migueldiaslima/drone-revB/README.md

# drone-revB

Quadcopter frame rev B (3.5 inch true X, PET-CF, topology-optimised with Abaqus/Tosca). Owner: Miguel Dias de Lima.

## Layout

| Folder | Content |
|---|---|
| `docs/` | All project docs, plus the Stage 2 theory document `stage2_sizing_model_first_principles_rev34.md` / `.pdf` (Chapters 0 to 10, Appendices A and B, references; Claude Docs rev 34) (copies of the claude.ai project "Drone Rework"). `journal_quadcopter.md` is the master record |
| `geometry/v04B/` | Current export, v04-B revision 2: TUB, LID, ARM_xx, KEEPOUTS, COMPONENTS (STEP), reference points, volumes and gate results |
| `geometry/v03B_arms/` | v03-B arm STEPs (D-054 split), kept for reference |
| `scripts/geometry_main/` | Main-chat generators and gates (CadQuery, gmsh, renders) |
| `scripts/cae_v03B/` | Abaqus/CAE 2022 scripts for the v03-B model (R1 to R13) |
| `scripts/cae_v04B/` | Abaqus/CAE 2022 scripts for v04-B (V1 build, V2 mesh, V3 jobs, W1/W2 Tosca task, D1 diagnostics) |
| `scripts/hpc/` | nexus run scripts and checks per run: H0H1, H2, H3ref, H3, G7, H4, threshold, TH04 |
| `scripts/post/` | Post-processing (iso surfaces, cycle checks) |
| `figures/` | Figures used in the docs |

Not in the repo (size): odb, inp, par, cae, stl. Those live on nexus (`/tmp/mdias_*`, `~/drone_revB/stage6`) and on Miguel's laptop.

## Status (2026-10-14)

| Item | State |
|---|---|
| Journal | v0.60 (D-001 to D-090) |
| Build log | items 1 to 69, DV-1 to DV-28 |
| H4 (v04-B rev 2) | converged at cycle 31; TH04b_ni passes, TH04a_ni fails as expected (N-06-17, N-06-18); antenna boss island F-036 |
| v04-B revision 3 (D-084, antenna spine) | exported to `geometry/v04B_r3/`, gates G0 to G5 pass (`docs/stage6_v04B_r3_export_note.md`); boss 5 island in H4 cycle 31 (F-037) |
| v04-B revision 4 (D-086, GPS deck on the TUB, four lid bosses) | exported to `geometry/v04B_r4/`, gates G0 to G5 pass (`docs/stage6_v04B_r4_export_note.md`) |
| H4 (v04-B rev 4) | converged at cycle 28; TH at iso 0.4 fails on the GPS deck (F-038); keels A + B with the keel zone cleaned pass (TH_r4b_cAB, N-06-21) |
| Keels A and B (D-087) | exact solids in `geometry/v04B_r4_keels/` (`docs/stage6_v04B_r4_keels_export_note.md`) |
| Receiver cradle, GPS cap | v2 in `geometry/retainers/` (`docs/retainer_rx_cradle_note.md`, `docs/retainer_gps_cap_note.md`) |
| Stages 6 and 7 | closed 2026-10-14: print set iso 0.3 (frame 89.22 g), strength PASS (about 25 x), D-050 not met (F-040, D-090); `docs/stage6_v04B_H4_report.md`, `docs/stage7_strength_report.md` |
| Reports | done 2026-10-14: compact (17 pages, sent) and extensive (123 pages) in `report/`; build zips with `bash report/make_overleaf.sh` |

## Open tasks

| # | Task | Owner |
|---|---|---|
| 1 | Report (about 15 pages, LaTeX) from journal Section 4 | Miguel, main chat |
| 2 | TPU skid | main chat |
| 3 | Q-58, Q-59, Q-63 (GPS wiring, plugs, height); Q-60 at the first cradle fit | Miguel |
| 4 | Future work: joint redesign for a defined up-down fuse (D-090); mass against R-01 (F-039) | - |

See `CLAUDE.md` for the working rules.
