migueldiaslima/drone-revB/report/extensive/main.tex

\documentclass[a4paper,11pt,oneside,parskip=half,toc=bibliography]{scrreprt}
\input{../common/preamble}
\input{../common/macros}
\title{From first principles to a printed airframe}
\subtitle{Sizing, topology optimisation and verification of a 3.5-inch quadcopter in PET-CF\\[4pt]
  \normalsize 3.5-inch quadcopter frame, Siraya PET-CF, Abaqus/Tosca}
\author{Miguel Dias de Lima\\ \small migueldiaslima@gmail.com}
\date{Latest revision: October 2026}
\begin{document}
\begin{titlepage}
\centering
\vspace*{\fill}
\par
\vspace{14mm}
{\usekomafont{title}\Huge From first principles to a printed airframe\par}
\vspace{5mm}
{\usekomafont{subtitle}\large Sizing, topology optimisation and verification of a 3.5-inch quadcopter in PET-CF\par}
\vspace{3mm}
{\normalsize 3.5-inch quadcopter frame, Siraya PET-CF, Abaqus/Tosca\par}
\vspace{12mm}
{\Large Miguel Dias de Lima\par}
\vspace{2mm}
{\small migueldiaslima@gmail.com\par}
\vspace{10mm}
{\normalsize Latest revision: October 2026\par}
\vspace*{\fill}
\end{titlepage}
\tableofcontents
\input{chapters/01_introduction}
\input{chapters/02_requirements}
\input{chapters/03_sizing}
\input{chapters/04_loads}
\input{chapters/05_material}
\input{chapters/06_architecture}
\input{chapters/07_topopt_theory}
\input{chapters/08_optimisation_model}
\input{chapters/09_iterations}
\input{chapters/10_verification}
\input{chapters/11_strength}
\input{chapters/11b_capacity}
\input{chapters/12_retainers}
\input{chapters/13_results}
\appendix
\input{chapters/A_logs}
\input{chapters/B_workflow}
\bibliographystyle{unsrtnat}
\bibliography{../common/references}
\end{document}
