migueldiaslima/drone-revB/report/compact/sections/07_iterations.tex

% 07_iterations.tex
\section{Verification and design-space iterations}\label{sec:iterations}

The optimiser returns a density field, not a part. The printed part is the region above an iso level of that field, so every result is verified on its thresholded form: elements above the iso level are solid, all others are set to near-zero stiffness, and the modes and compliances are recomputed. Three findings came out of this check, and each changed the design space.

\subsection{Disconnected fixed region at the antenna mount}

The receiver antenna was first held by a small fixed boss under the rear keel. In the optimisation that boss touched only design material and carried no load and no mass, because the antenna mass sat in a lumped point mass at the flight controller. Nothing required a path to it, so Tosca removed the keel material around it. Thresholded, the boss was a loose part with six rigid-body modes between 45 and 200\,Hz. The fix routed the antenna cable through a fixed sleeve that runs from the bay into the keel, ends in a pad under the keel and joins the rear lid boss, so the mount can no longer be cut loose, and the antenna mass now acts on that pad. This became a design-space rule: every fixed region either touches other fixed material or carries a load, a tie or a mass that needs a solid path.

\subsection{Inter-part dependency of fixed regions}

The rule was then applied part by part. A lid boss on the keel carried the tie to the lid, and in the assembled model the lid held it. Checked on the tub alone, the boss was an island: the optimiser had used the lid as its support and removed the keel behind it. The GPS deck, then part of the lid, also hung from the lid. The deck moved to the tub, on top of the keel, and the keel boss was deleted, so the GPS mass needs a load path through the tub and the lid no longer supports anything it does not own.

\subsection{Intermediate-density support of the GPS deck}

With the deck on the tub the connectivity check passed at every iso level from 0.3 to 0.5, yet the thresholded model failed: the first elastic mode was a GPS deck mode at \SI{146.8}{Hz}. In the optimisation the deck was carried at \SI{461.7}{Hz} by a wide block of keel material with densities mostly below 0.15. Such material is penalised in stiffness but still contributes, and no threshold keeps it, so the printed deck hung from two thin straps.

Five supports were tested on the saved density field without a new optimisation (\cref{tab:keels}). A local low threshold failed, so the optimiser had not formed a structure there at all. Two full side webs passed. Web B alone does not reach the deck and fails. The adopted design cleans the keel zone of all design material and adds two shapes drawn by hand: twin tapered keels hanging from the deck (A), whose depth grows towards the rear wall where their bending moment is largest, and a thin web under the antenna sleeve (B) that braces the antenna mount (\cref{fig:keels}).

\begin{table}[htbp]
\centering\small
\caption{Supports for the GPS deck, checked on the thresholded density field of the production run.}\label{tab:keels}
\begin{tabular}{@{}lcccc@{}}
\toprule
Support & Model mass & First elastic mode & LC3a compliance / cap & Result\\
\midrule
As optimised, iso 0.4 & \SI{281.3}{g} & \SI{146.8}{Hz} & 1.20 & fail\\
Local iso 0.15 in the keel & \SI{281.5}{g} & \SI{380.6}{Hz} & 0.99 & fail\\
Two side webs & \SI{283.4}{g} & \SI{430.7}{Hz} & 0.93 & pass\\
Keel zone cleaned, web B only & \SI{281.1}{g} & \SI{7.8}{Hz} & 28.05 & fail\\
Keel zone cleaned, keels A & \SI{282.2}{g} & \SI{420.7}{Hz} & 0.95 & pass\\
Keel zone cleaned, keels A and web B & \SI{282.3}{g} & \SI{428.4}{Hz} & 0.94 & pass\\
\bottomrule
\end{tabular}
\end{table}

Keels A and web B meet every requirement with \SI{1.1}{g} less than the side webs at the same margins. Their exact solids were drawn for printing: each end stops with a face at least 1\,mm deep, and every piece is at least 1.2\,mm wide.

\begin{figure}[htbp]
\centering
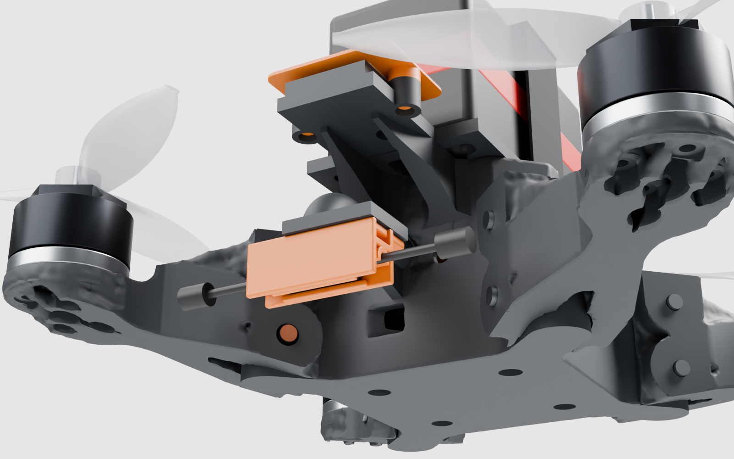
[picture p8: report/figures/R5_rear_underside.png]

\caption{Rear underside of the tub: twin keels under the GPS deck, the web under the antenna sleeve, the antenna pad and holder.}\label{fig:keels}
\end{figure}

The lesson is that connectivity is not stiffness. The connectivity rule became a stiffness rule: a fixed part that carries a mass gets either a fixed load path to the main structure or a design corridor narrow enough that the optimiser must form a member in it, and the thresholded model, not the island check, decides. Running a coarse rehearsal and a thresholded check on its saved cycles before a long production run would have shown this in hours.
