migueldiaslima/drone-revB/docs/stage6_update_since_H1.md

# Stage 6: update for the main chat, from H1 to the v04-B redesign

From the Abaqus set-up chat, 2026-10-11. Covers everything since the last message to the main chat (H0 and H1 passed, 2026-10-09 evening). Read with:
- `claude/stage6_v04B_design_brief.md`: the redesign brief (part B of this update);
- `claude/stage6_hpc_H2_report.md`: H2 and the H3 interim (written 2026-10-10 morning, superseded where this note differs);
- `claude/stage6_concepts_explained.md`: explanations of the density field, iso surfaces, member size, mode check and the measured Tosca interpolation;
- `claude/stage6_build_log_v03B.md`: full record, Phase H items 7 to 31, DV-19 to DV-21, F-15, F-16.

## 1. Summary

| Item | Result |
|---|---|
| H2 (2.5 / 1.5 mm, nemix) | stopped at cycle 10 by the D-066 mode rule; not converged |
| H3 reference (1.0 mm, nexus) | done; mesh-converged against 2.5 / 1.5 within 1.3 % (frequency) and 1.8 % (strain energy); H3 caps set |
| H3 (1.0 mm, member size 2.5 mm, nexus) | started before the H2 review (DV-21); feasible from cycle 28; stopped by hand after cycle 40 |
| D-066 items 1 to 3 | closed: interpolation measured; flagged modes are grey arm bending modes, not spurious; thresholded designs at iso 0.3 and 0.5 pass every constraint and are stiffer than Tosca predicted |
| Print set v03-B | cycle 40 at iso 0.4, smoothed, interfaces restored: body 45.58 g, arm 7.81 g, frame 76.8 g, AUW about 282 g |
| R-01 (AUW < 250 g) | not met; Miguel: 250 g is not achievable with this concept, accepted; mass for assembly features accepted |
| F-16 | the print set cannot be assembled: the FC bay is closed on every side |
| Redesign v04-B | optimised tub plus removable lid, a dedicated retainer for every component, new GPS, capacitor flipped over the FC (option 2, confirmed by Miguel); brief written |

## 2. Decisions received and how they were applied

| Decision | Applied as |
|---|---|
| D-064 (3-2-1 supports with inertia relief) | already in the model (DV-18); every run reported the reactions |
| D-065 (H2 settings) | applied with two deviations made at Miguel's request: DV-19 (resources) and DV-20 (save every cycle) |
| D-066 (C-3 checks) | item 2 automated in a watcher on H2 and in `cyclecheck.py` on H3; items 1 and 3 answered from H3 cycle 40 (section 6) |

## 3. H2 on nemix

1. Bench before H2 (Miguel: nemix free for full use, finish as fast as possible). H0 input at 32 cores: 88 s against 137 s at 16 cores, results identical to H0 (reactions below 2.5e-11 N). Memory does not speed the run (peak 9 GB). Resources raised to 32 cores, thread mode, memory 90 % (DV-19).
2. Save rule: every cycle instead of every 5 (DV-20). Reason: the every-N syntax of the Tosca 2025 save rule could not be confirmed, and a wrong edit could lose the results; disk was not a limit (2.8 TB free).
3. F-15. The first start failed in cycle 0: Abaqus 2025 does not support adjoint sensitivities with inertia relief, nor with the eigenvalue step, in MPI mode, and at 32 cores across two sockets it chose MPI (at 16 cores in H0 and H1 it had chosen threads). Fix: `mp_mode=threads` in the `.par` solver arguments (`driver.Solver.AddCallArgs = ['cpus=32','memory=90%','mp_mode=threads']`). The second start failed because `mp_mode` had also been put on the `abq2025 optimization` command line, which rejects it. Third start ran (00:46, 2026-10-10).
4. Watcher (`h2_watch.sh` with `h2_modecheck.py`): every 60 s it checked the saved odb of cycles 5, 10, ... and stopped H2 on a D-066 flag. Two bugs fixed during the night: zero-padded cycle numbers read as octal by bash (fixed with `10#`), and a support-reaction check that printed 0 N because the Tosca odb flattens the model into one instance (`PART-1-1`) so the assembly node sets were not found (fixed later in `cyclecheck.py`).
5. Stop. The watcher stopped H2 at cycle 10 (01:28): modes 8, 9, 10 (417.0 / 418.2 / 419.7 Hz) had most of their peak nodes in elements below density 0.3, at the arm tips. Constraints at the stop: f7 407.3 Hz, LC3a strain energy 1.24 x cap. About 3.8 min per cycle at 32 threads, 11 GB on disk. History table: `claude/stage6_hpc_H2_report.md`.

## 4. Second machine (nexus) and the 1.0 mm reference

1. Miguel had access to a second server (nexus: 2 x AMD EPYC 7513, 64 cores, 251 GB, Abaqus 2024). Used it so that the production mesh could be prepared in parallel with the H2 review.
2. `R13_mesh10.py` remeshed BODY and ARM at 1.0 mm in a Save As copy (`revB_v03B_m10.cae`) and wrote `H3_ref.inp`.
3. H3 reference job: 723,474 C3D10, 3.19 M variables, 671 s on 64 threads, peak 80 GB.

| Quantity | 1.0 mm | 2.5 / 1.5 mm | Difference |
|---|---|---|---|
| Mass | 333.69 g | 333.70 g | 0.00 % |
| f7 to f12 (Hz) | 486.66 / 517.87 / 520.97 / 568.67 / 673.31 / 742.66 | 489.93 / 521.51 / 524.32 / 573.63 / 681.81 / 749.44 | -0.6 to -1.3 % |
| ALLSE LC1 / LC2a / LC2b / LC3a (N mm) | 0.0919015 / 0.0709504 / 0.0461905 / 0.106569 | 0.090893 / 0.069877 / 0.045459 / 0.10466 | +1.1 to +1.8 % |
| H3 caps (D-063, 2 x ALLSE) | 0.183803 / 0.141901 / 0.0923811 / 0.213138 | | |
| Support reactions | below 3.7e-10 N | below 1.5e-11 N | |

4. S24 smoke test (Tosca 2024 on nexus, H1 files, 2 cycles): identical to H1; Tosca 2024 accepts inertia relief with the sensitivity-based algorithm. PASS.

## 5. H3 on nexus

1. Started about 02:00 on 2026-10-10, before the main chat had reviewed H2 (DV-21). Miguel's reason: deadline; the risk of a wasted run was accepted.
2. Settings: 1.0 mm mesh, H3 caps, member size 2.5 mm (`GR_MS`, minimum thickness, on `DESIGN_ALL`), max 60 cycles, save every 10 plus the last, 54 cores (10 left to another user), thread mode, memory 80 %, run directory `/tmp` (root disk 567 GB free; `/home` had 38 GB). Otherwise as H2.
3. History: overshoot at cycles 13 to 20 (volume down to 27,159 mm^3, f7 down to 341 Hz, LC3a up to 1.98 x cap), recovery from cycle 25, all constraints within about 1 % from cycle 28, then a slow volume decrease (about -0.8 % per cycle). About 14 min per cycle.
4. Mode check (`cyclecheck.py`): cycle 10 clean; cycle 20 modes 9 and 10 flagged; cycle 30 all six modes flagged (every one peaking at an arm tip, mean density in the peak region 0.20 to 0.34). Reactions below 9.8e-10 N in every step.
5. Miguel did not stop H3 until the question "can we still extract a printable structure?" was answered. It was answered with the iso surfaces of cycle 33 (section 7), and H3 was stopped after cycle 40 (12:37). Cycle 40 was frozen (`TO_v03B_H3-Job.inp` from `SAVE.inp/040`, `tosca_distribution.inp`, `c40.odb`). The pruner had deleted the cycle 32 odb, so cycle 33 was used for the first surfaces.
6. Cycle 40 (Tosca): f7 to f12 = 417.8 / 419.7 / 420.5 / 427.3 / 487.1 / 521.2 Hz; SE / cap = 0.98 / 1.00 / 1.00 / 1.00. Feasible, active on f7 and the three strain-energy cases LC2a, LC2b, LC3a.

## 6. D-066 closed

### Item 1: how Tosca treats grey material

Tosca 2024 writes each element's interpolated stiffness and mass as `*SCALESTIFFNESS` / `*SCALEMASS` distribution tables in the saved input, so the interpolation was measured rather than looked up. Mass is linear in density (100 x lower at density 0.001). Stiffness is about 0.19 x density at low density and rises towards density^3 near 1. The stiffness-to-mass ratio of intermediate material is below that of solid at every density: grey material is never a bargain (it is penalised), and void regions are protected against local modes because their mass falls with their stiffness. Full table and explanation: `claude/stage6_concepts_explained.md` section 9.

### Item 2: what the flagged modes are

The flagged modes are the arm bending modes (umbrella, saddle pair, in-plane), with their largest motion at the motor seats, where the converged design has thinner, partly grey material. They are not void-region modes at low frequency (those would appear at a few tens of Hz and peak inside near-void elements). The D-066 rule ("more than half of the peak nodes touch only elements below 0.3") flags them because the arm tips are both where the mode moves most and where Tosca thins the arm. The rule detects grey material in a mode, not a spurious mode.

### Item 3: thresholded frequency jobs (decisive check)

`threshold_job.py` took the cycle 40 input and replaced Tosca's distributions: elements at or above the iso value solid (factor 1), the rest near-air (stiffness 1e-6, mass 1e-9); all Tosca response keywords removed (the first attempt failed on orphaned `*GLOBALRESPONSE` keywords; all `*...RESPONSE` blocks are now stripped). Plain Abaqus runs on nexus, 27 cores each.

| Case | Solid elements | Whole-model mass | f7 to f12 (Hz) | SE / cap LC1 / LC2a / LC2b / LC3a |
|---|---|---|---|---|
| Tosca cycle 40 (grey) | 723,451 (graded) | | 417.8 / 419.7 / 420.5 / 427.3 / 487.1 / 521.2 | 0.98 / 1.00 / 1.00 / 1.00 |
| TH05 (iso 0.5) | 437,027 | 277.2 g | 438.3 / 446.1 / 450.8 / 456.5 / 515.6 / 547.4 | 0.86 / 0.86 / 0.92 / 0.93 |
| TH03 (iso 0.3) | 457,918 | 281.3 g | 449.5 / 462.5 / 465.8 / 488.2 / 544.8 / 574.9 | 0.77 / 0.76 / 0.82 / 0.84 |

Reactions TH05: 3.9e-10 / 1.5e-9 / 7.3e-10 / 3.7e-10 N (pass).

Reading: both cuts meet 417 Hz and every cap. The thresholded parts are stiffer than Tosca's grey model (f7 +4.9 % at iso 0.5, +7.6 % at iso 0.3), because the solid elements kept are fully stiff while Tosca counted the grey ones at less than their mass share (item 1). Grey material was not overcredited. The D-066 pass criterion (thresholded within 5 % of Tosca, not lower) is met on the safe side.

Consequence for the rule: the D-066 item 2 stop rule stopped H2 and would have stopped H3 at cycle 20 on a design that, once thresholded, passes. Proposal (decision 4 in the brief): keep the mode check as a reported diagnostic and make the thresholded job the acceptance check.

## 7. From density field to a printable part

1. Separation (cycle 33, design elements): 47 % below 0.3, 5 % between 0.3 and 0.5, 48 % at or above 0.5. The field is well separated, so the iso level moves the surface by a fraction of an element in most places.
2. Iso surfaces: marching tetrahedra on the C3D10 corner nodes with nodal densities, canonical edge interpolation (`iso_mt.py`), then 6 Taubin iterations (smoothing without shrinkage). Body and four identical arms, closed and manifold.
3. Mass at cycle 40 (before restoration): iso 0.5 frame 54,742 mm^3 = 71.2 g; iso 0.4 58,943 mm^3 = 76.6 g.
4. Wall thickness, two independent methods:

| Method | Arm iso 0.5 | Arm iso 0.4 | Body iso 0.5 | Body iso 0.4 |
|---|---|---|---|---|
| Ray along the inward normal, median / surface share below 1.2 mm | 3.09 mm / 5.1 % | 3.28 mm / 2.7 % | 2.52 mm / 7.3 % | 2.77 mm / 3.7 % |
| Sphere (local thickness), surface share below 0.8 / 1.2 / 2.0 / 2.5 mm | 0.9 / 3.8 / 23 / 43 % | 0.8 / 2.2 / 15 / 37 % | 0.2 / 2.3 / 10 / 23 % | 0.1 / 1.0 / 5 / 15 % |

Sphere method: voxels 0.1 mm (arm) and 0.25 mm (body; 0.15 and 0.2 mm ran out of memory). The ray method is pessimistic at edges and agrees with the sphere method on the arm below 2 mm. Material volume below 1.2 mm: 0.4 to 1.2 %. Thin spots are local: body side walls by the FC bay and the plate supports, arm top web at mid-length.

5. Iso level chosen: 0.4. It halves the thin surface share of iso 0.5 for 5.4 g, and its frequencies lie between two thresholded designs that both pass (TH05, TH03; iso 0.4 itself not run, see the brief, check T-4).
6. Restoration (D-044): final = (iso surface UNION exact fixed solids) INTERSECT exact envelope, with the STEP solids meshed by gmsh at 0.3 mm and booleans in manifold3d. The first BODY.step uploaded was an older version (23 solids); the correct D-056 file has 14 solids (design 42,206.2, fixed 12,597.9 mm^3).

| Part | Iso 0.4 | Fixed restored | Outside envelope trimmed | Final |
|---|---|---|---|---|
| Body | 35,095 mm^3 | 868 mm^3 (plate skin 349 mm^3, about 0.06 mm per face; fin bosses about 63 mm^3 each) | 901 mm^3 (films and fills in component voids, windows, holes) | 35,062 mm^3 = 45.58 g |
| Arm (x4, identical) | 5,962 mm^3 | 168 mm^3 (boss and pad skins, mean 0.06 mm) | 119 mm^3 (four bolt-hole fills of about 12.5 mm^3, one pocket, a 0.02 mm film) | 6,011 mm^3 = 7.81 g |

Frame 45.58 + 4 x 7.81 = 76.8 g; AUW about 282 g with the 205.4 g of point masses. Files: `revB_v03B_BODY_c40_iso040.stl`, `revB_v03B_ARM_c40_iso040_print4.stl`.

## 8. Mass and R-01

| Item | Value |
|---|---|
| B allowance for design material (Q-53) | about 13 g |
| Design material in the print set (76.8 - 31.6 fixed) | about 45 g |
| Frame / AUW | 76.8 g / about 282 g |
| Volador reference frame | 70.5 g |

At 417 Hz with this design space the frame needs about three times the B allowance. Miguel: 250 g is not achievable with this concept; accepted; adding mass for assembly is acceptable. The D-035 sweep (350 / 290 Hz) and variant C are not run now (Miguel). Proposed record: decision 2 in the brief.

## 9. Assembly review (F-16) and why a redesign

Looking at the print set as a part to build, not as a structure:
- The FC bay is closed. Openings seen from the bay: USB-C window 12 x 8 mm (-y wall, z -2 to 6), strap tunnel 18 x 3.5 mm (both y walls, z 18 to 21.5), a 4 x 4 mm passage at the foot of each wall (z -6 to -3, motor leads), 1 to 3 mm slits at the wall corners. The roof is closed (fixed battery plate plus an optimised ceiling at z 18 to 20).
- The FC cannot be inserted from any side: design material blocks it (+x 798, -x 861, +y 778, -y 607 mm^3; fixed material only 6 mm^3); from the top, the fixed plate.
- The FC boss holes are blind (z -13 to -6, 2 mm floor), with no screwdriver line from above.
- No passage for the battery lead (D-029 front), the GPS cable or the receiver antenna.
- Motors, props, battery plate and strap, USB-C and the arm joint are fine: they were exact fixed regions and keep-outs.

Cause: the design space defined where components sit (D-032 voids) but not how they get there. Tosca filled every assembly path, as it should.

Miguel's requirements for the redesign (all from the discussion):
1. Think higher-level changes; do not restrict to the current design; everything must assemble easily.
2. A designed space and retention feature for every component; no glue, no tape.
3. Include the accessories: XT30 pigtail (7 cm) with capacitor, receiver wires and antenna, GPS cable.
4. Verify the space available at each assembly step (for example, the FC lowered over raised screws).
5. The capacitor joint must not be bent near the solder.
6. Hold the FC nut and screw from below, through a large FC opening, rather than nut-driver holes.
7. Lid screws: yes. Components under the FC (grommet stack, nuts) fine; nylon nut above the receiver ear fine; anti-loosening nut 2.5 mm above the grommet.
8. 250 g not achievable; added mass for assembly accepted.
9. Capacitor: option 2 (flipped 180 deg over the FC), confirmed 2026-10-11.

The resulting design is in `claude/stage6_v04B_design_brief.md`.

## 10. Lessons

| # | Lesson |
|---|---|
| L-a | A rule written to detect one failure (spurious void modes) also fired on a legitimate state (grey arm tips in bending modes). The thresholded job, which measures the printable part directly, was the decisive test; it should have been the acceptance test from the start |
| L-b | A design space must contain assembly paths, not only component volumes. Every component needs an insertion path, a tool path and a cable path as keep-outs |
| L-c | Check the identity of every input file (solid count, volumes) before use: the first BODY.step was an older export |
| L-d | Tosca odbs are flattened to one instance; scripts that look for assembly sets in them must search instance sets |

## 11. Numbers for the register (proposed)

| ID | Quantity |
|---|---|
| N-06-09 | H2 (2.5 / 1.5 mm, nemix, 32 threads): stopped at cycle 10 by the D-066 rule; cycle 10 f7 to f12 407.3 / 417.0 / 418.2 / 419.7 / 456.3 / 486.3 Hz; about 3.8 min per cycle |
| N-06-10 | H3 reference (1.0 mm, 723,474 C3D10): values of section 4 |
| N-06-11 | H3 cycle 40 (Tosca): f7 to f12 417.8 / 419.7 / 420.5 / 427.3 / 487.1 / 521.2 Hz, SE / cap 0.98 / 1.00 / 1.00 / 1.00; about 14 min per cycle at 54 threads |
| N-06-12 | Thresholded cycle 40: TH05 and TH03 rows of section 6 |
| N-06-13 | Print set v03-B iso 0.4 restored: body 35,062 mm^3 = 45.58 g, arm 6,011 mm^3 = 7.81 g, frame 76.8 g, AUW about 282 g |
| N-06-14 | Wall thickness table of section 7 |
