migueldiaslima/drone-revB/docs/stage6_v04B_checks_explained.md

# Stage 6: the eight v04-B layout checks, explained

Companion to `claude/stage6_v04B_design_brief.md` section 9. Each check is explained from the basic rule it tests, with the numbers worked step by step, the options, and a verdict. Figures: `check1_plan.png` to `check6_capacitor.png` (sent in the set-up chat, 2026-10-11).

## 0. The rules every check uses

Five rules, all decided earlier in the project. Every check below is one of them applied to one feature.

| Rule | Where it comes from | What it means here |
|---|---|---|
| Prop keep-out | D-024, D-030: prop disc radius 44.45 mm plus a 3 mm margin = 47.45 mm around each motor axis, for z 10 to 21.5 (blades at 13 to 18.5, plus and minus 3) | nothing (frame, cable, connector) may enter that zone. The margin covers blade flex, print tolerance and arm deflection |
| Landing plane | D-036, D-037: the floor bottom (z = -15) is the lowest point of the frame; it is what touches the ground | nothing may hang below it, or it becomes the landing point |
| Tangency | D-054, D-055, F-031: two region boundaries must cross at a clear angle or stay at least one element (1 mm) apart | otherwise thin wedges or strips form that the mesher cannot fill (the v03-B arm failure) |
| Printable wall | D-057: about 3 extrusion lines | a wall thinner than about 1.2 mm cannot be printed reliably |
| Assembly path | F-16, requirement 4 of the redesign | a part must be able to travel from outside to its final place, with every other part already fitted in that step |

Positions use the model axes: x forward, y left, z up, origin at the frame centre, z = 0 on the arm top under the motor. The four motor axes are at (+-49.5, +-49.5).

## 1. FC insertion and the lid boss positions

### What was agreed

The FC is lowered from above into the open tub (lid off), and the lid is screwed to the tub with four bosses at the tub corners plus one on the keel.

### The basic fact: the top of the body is an octagon, not a square

Below z = 10 the body is a 40 x 40 square. Between z = 10 and the rim (z = 21.5) the body is the same square with its four corners cut off (D-030):

    |x| + |y| <= 31.8

Why the corners are cut: at that height the props sweep past. The front-left motor axis is at (49.5, 49.5), which is

    sqrt(49.5^2 + 49.5^2) = 70.0 mm

from the centre, along the diagonal. The keep-out circle around it has radius 47.45 mm, so along the diagonal it reaches in to

    70.0 - 47.45 = 22.55 mm

from the centre. The chamfer line |x| + |y| = 31.8 crosses the diagonal at

    31.8 / sqrt(2) = 22.5 mm

So the chamfer is exactly the prop keep-out. It cannot move outward.

### The numbers

The FC board is 33 x 33 mm. Its corner is at (16.5, 16.5), at a distance from the centre of

    sqrt(16.5^2 + 16.5^2) = 23.3 mm

along the diagonal. The octagon allows 22.5 mm there. The board corner is 0.8 mm outside the body before any clearance is added.

The same test written with the octagon rule: at the board corner

    |x| + |y| = 16.5 + 16.5 = 33.0

against the limit 31.8. With 0.5 mm of clearance all round (an insertion opening of 34 x 34) it is 34.0 against 31.8.

Analogy: a square tray that must pass through an octagonal hole whose flat-to-flat width (40 mm) is larger than the tray, but whose corner-to-corner reach along the diagonals (45 mm) is shorter than the tray's diagonal (46.7 mm). The tray fits in the hole's width but not across its corners.

### What goes wrong

The FC sits below z = 10 in its final position (z -6 to +5), where the body is the full square, so it fits where it lives. It cannot get there: on the way down it must pass through the octagon band (z 10 to 21.5).

To let it pass, the opening must be cut through the band as a 34 x 34 square. Figure `check1_plan.png` shows the consequence: the square opening removes the four chamfer corners completely. What remains of the band are four separate wall pieces, one per side, each 3 mm thick (from 17 to 20 mm out). There is no tub corner left above z = 10 to hold a boss.
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
