migueldiaslima/drone-revB/docs/stage6_v04B_export_note.md

# Stage 6: v04-B export note, revision 2 (46 x 46 body, 148.5 mm wheelbase, closed corners, fillets)

From the main chat, 2026-10-11. It replaces revisions 0 (40 x 40 body) and 1 of the same day; both are kept in the main chat (`abaqus_v04B_r0`, `abaqus_v04B_r1`). Read with `claude/stage6_v04B_design_brief.md`. Decisions D-067 to D-081 are in `claude/journal_quadcopter.md` (v0.51). Gates G0 to G5 all pass. Package: `stage6_abaqus_v04B.zip`.

## 0. Revision 2 changes (Miguel, 2026-10-11, D-081)

| # | Change | Detail |
|---|---|---|
| 1 | Octagonal corner walls restored above z = 10 | The bay above z = 10 follows the outer octagon with 2.5 mm corner walls (inner chamfer \|x\| + \|y\| <= 34.36). The FC still drops straight in: its corners clear the inner corner walls by 0.96 mm (C-1). Between z about 6 and 10 the bay corners rise at 45 deg from the R2 rounded corners to the corner walls, so the walls are continuous; at board level (z -6 to 6) the 4 mm margin and the corners are unchanged |
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
