migueldiaslima/drone-revB/figures/cap_options.png

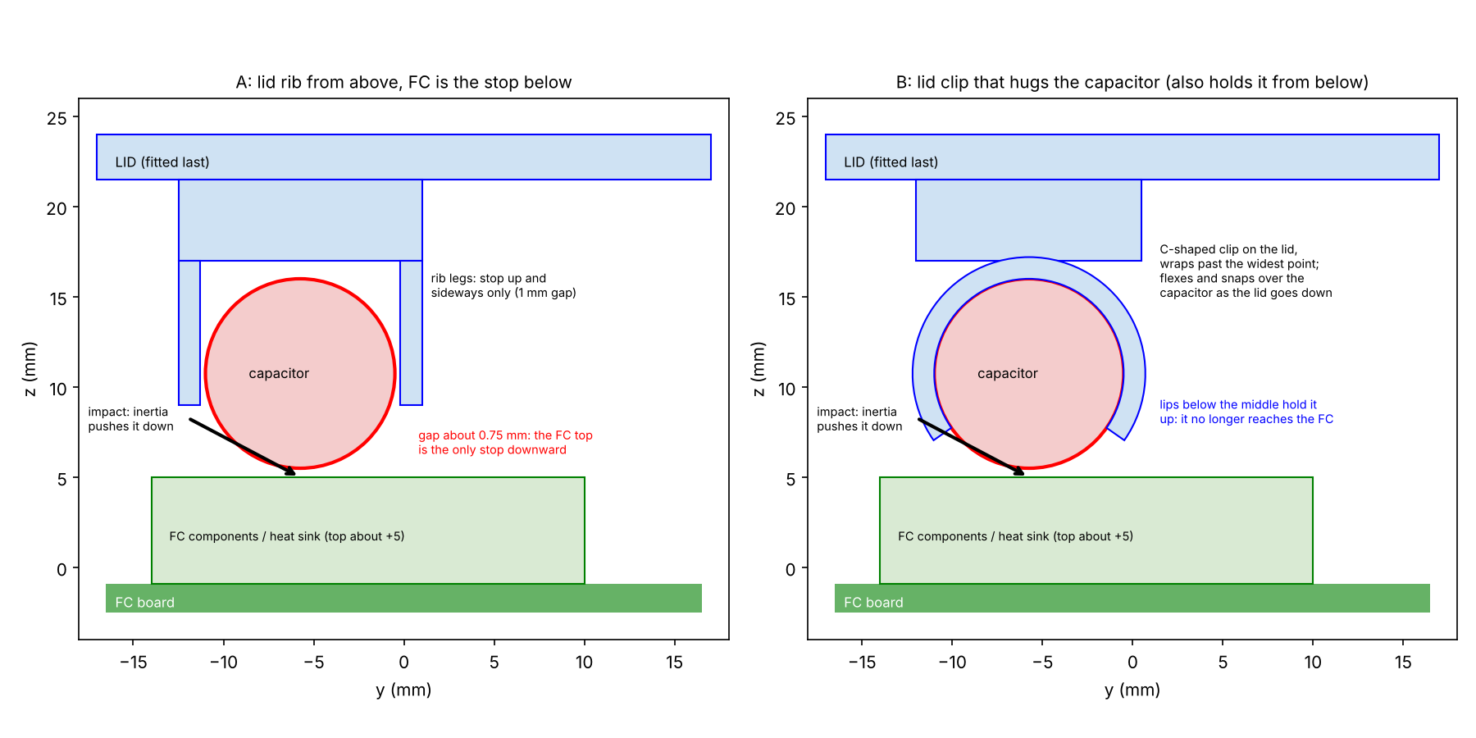
figures/cap_options.png
