migueldiaslima/drone-revB/figures/check1_plan.png

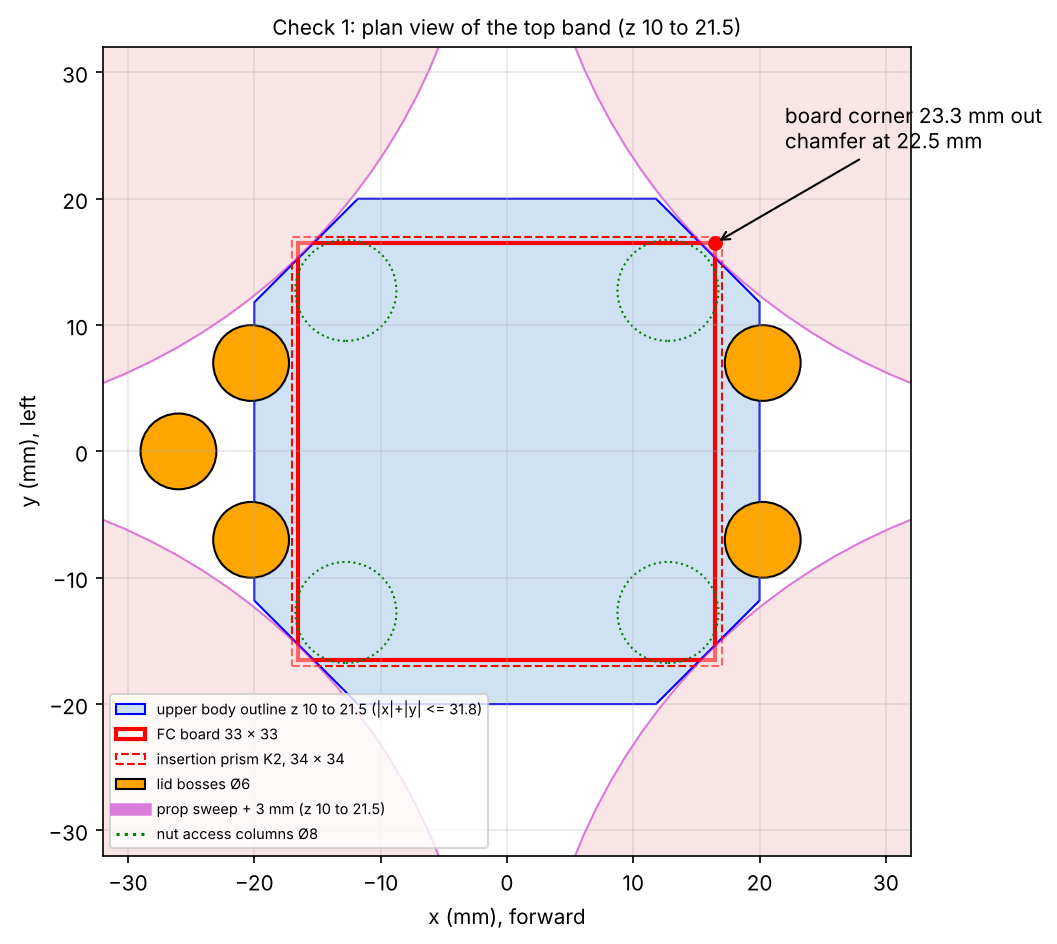
figures/check1_plan.png
