migueldiaslima/drone-revB/figures/check2_window.png

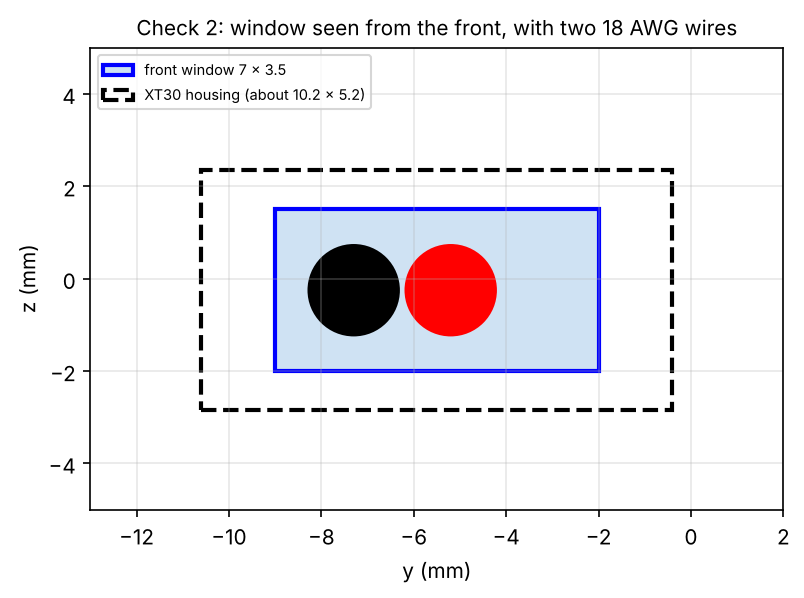
figures/check2_window.png
