migueldiaslima/drone-revB/figures/check3_keel.png

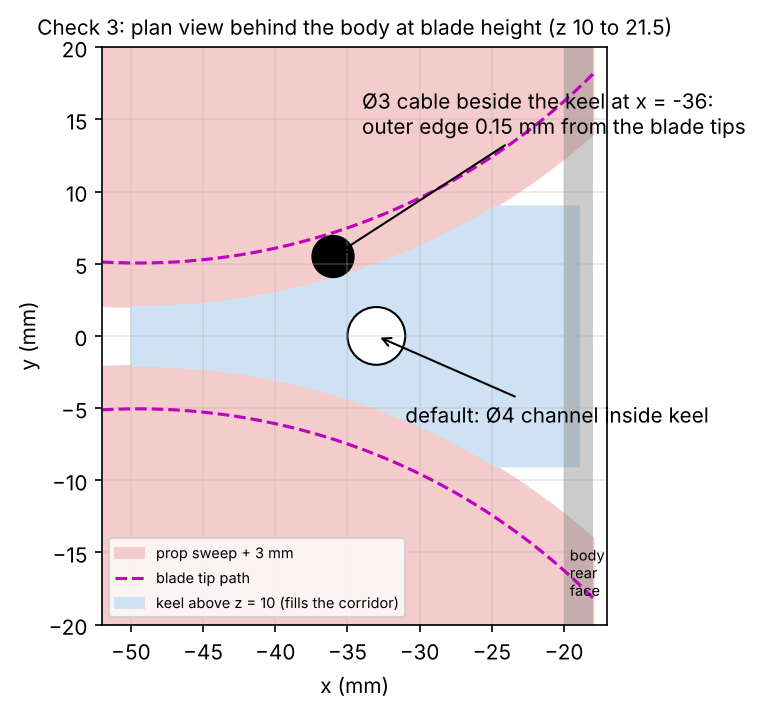
figures/check3_keel.png
