migueldiaslima/drone-revB/figures/check4_rearface.png

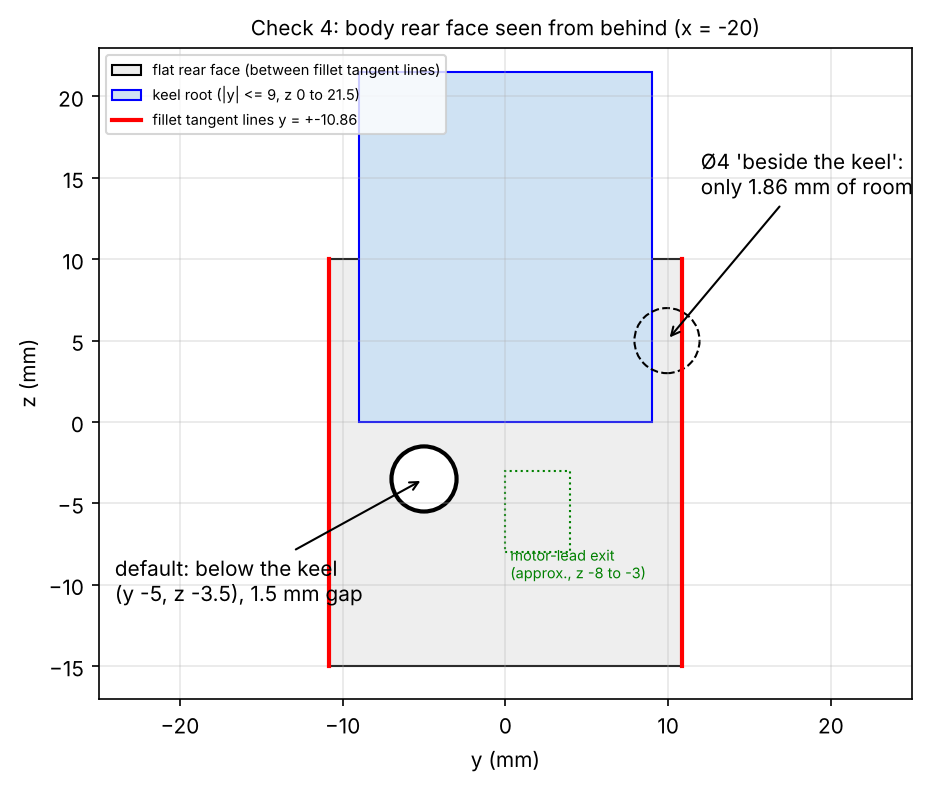
figures/check4_rearface.png
