migueldiaslima/drone-revB/figures/check5_antenna.png

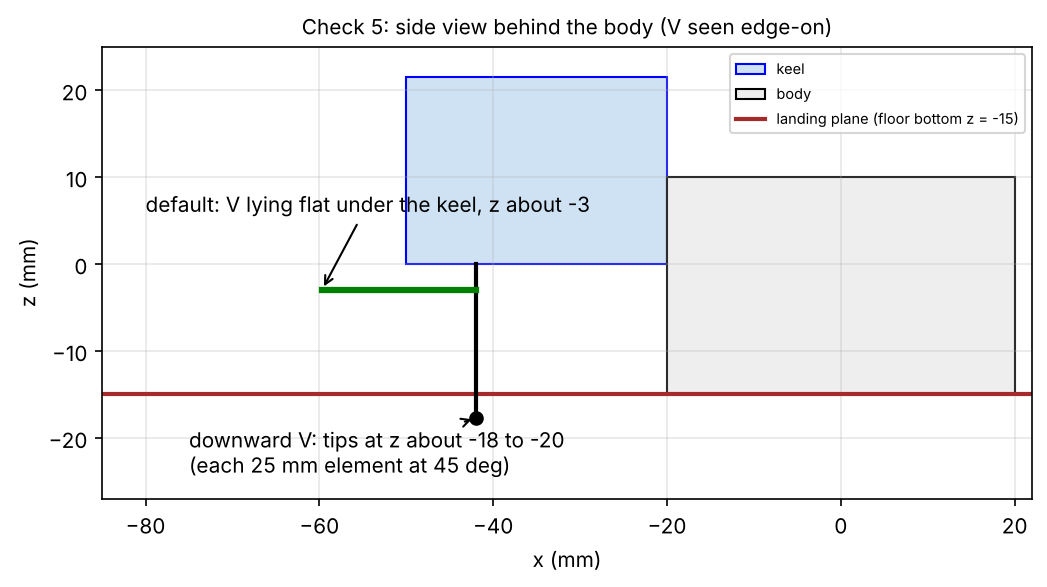
figures/check5_antenna.png
