migueldiaslima/drone-revB/figures/check6_capacitor.png

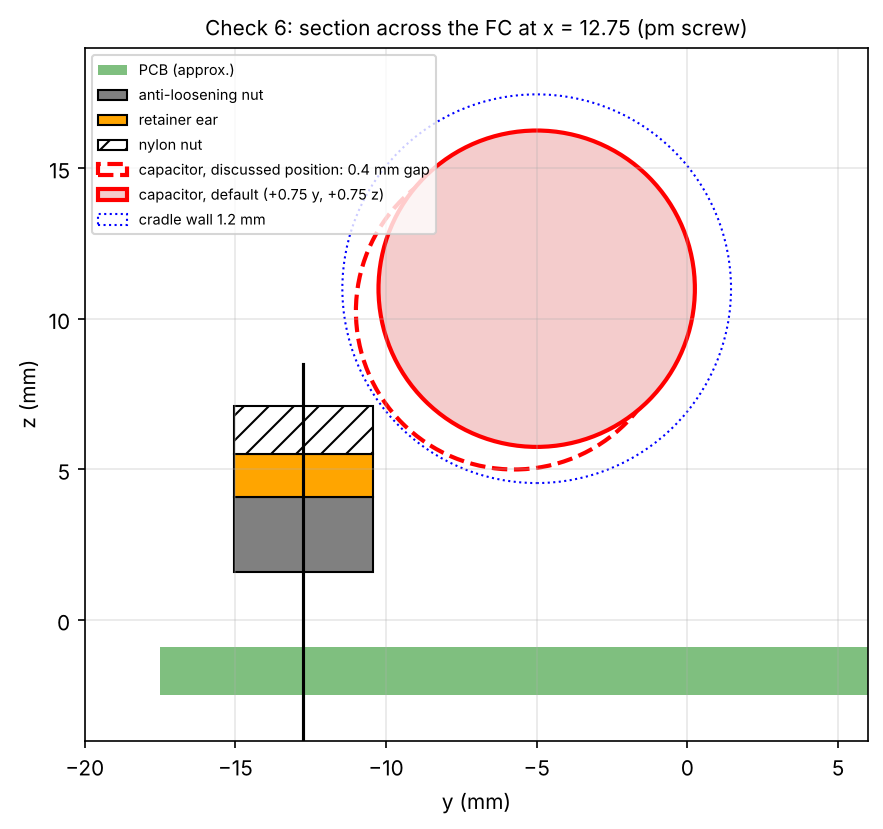
figures/check6_capacitor.png
