migueldiaslima/drone-revB/figures/f17_1_current.png

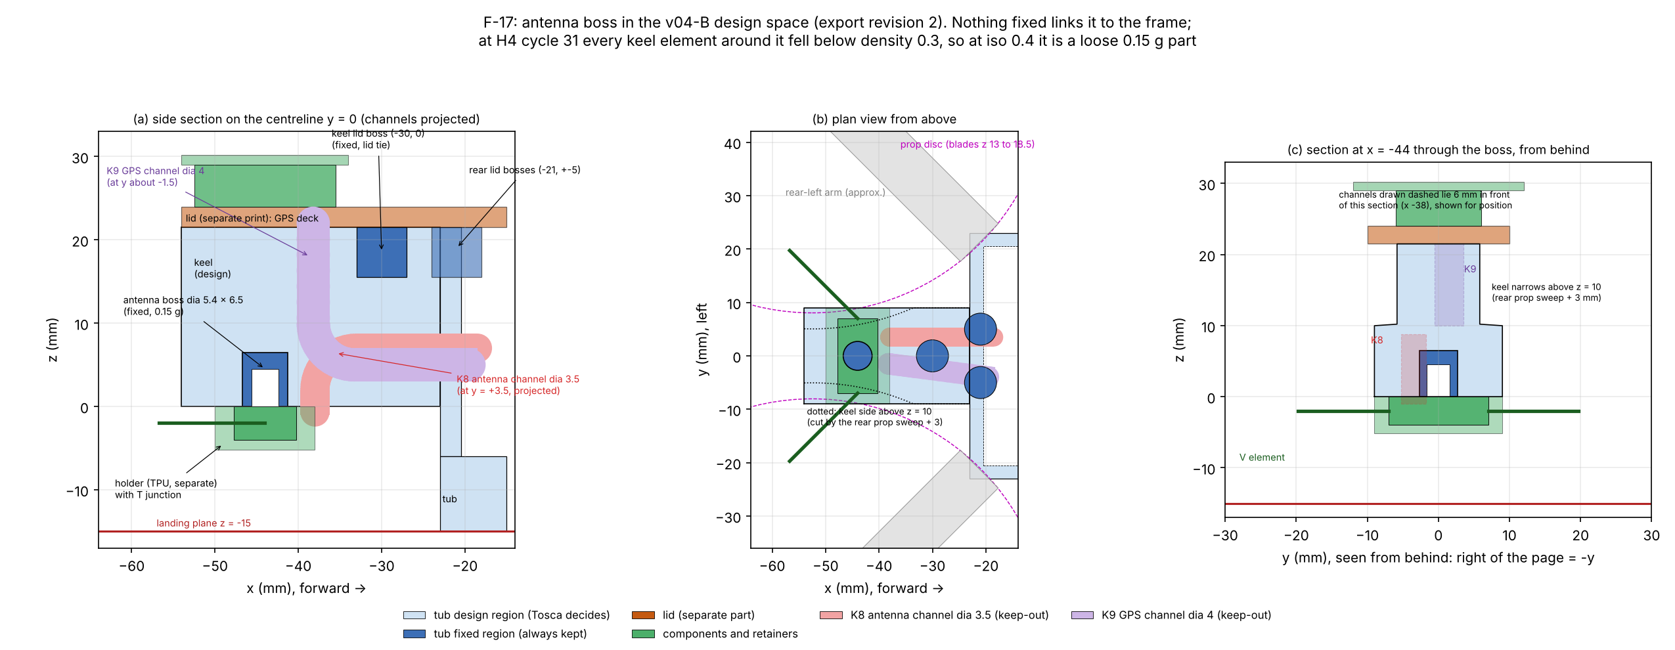
figures/f17_1_current.png
