migueldiaslima/drone-revB/figures/f17_2_link.png

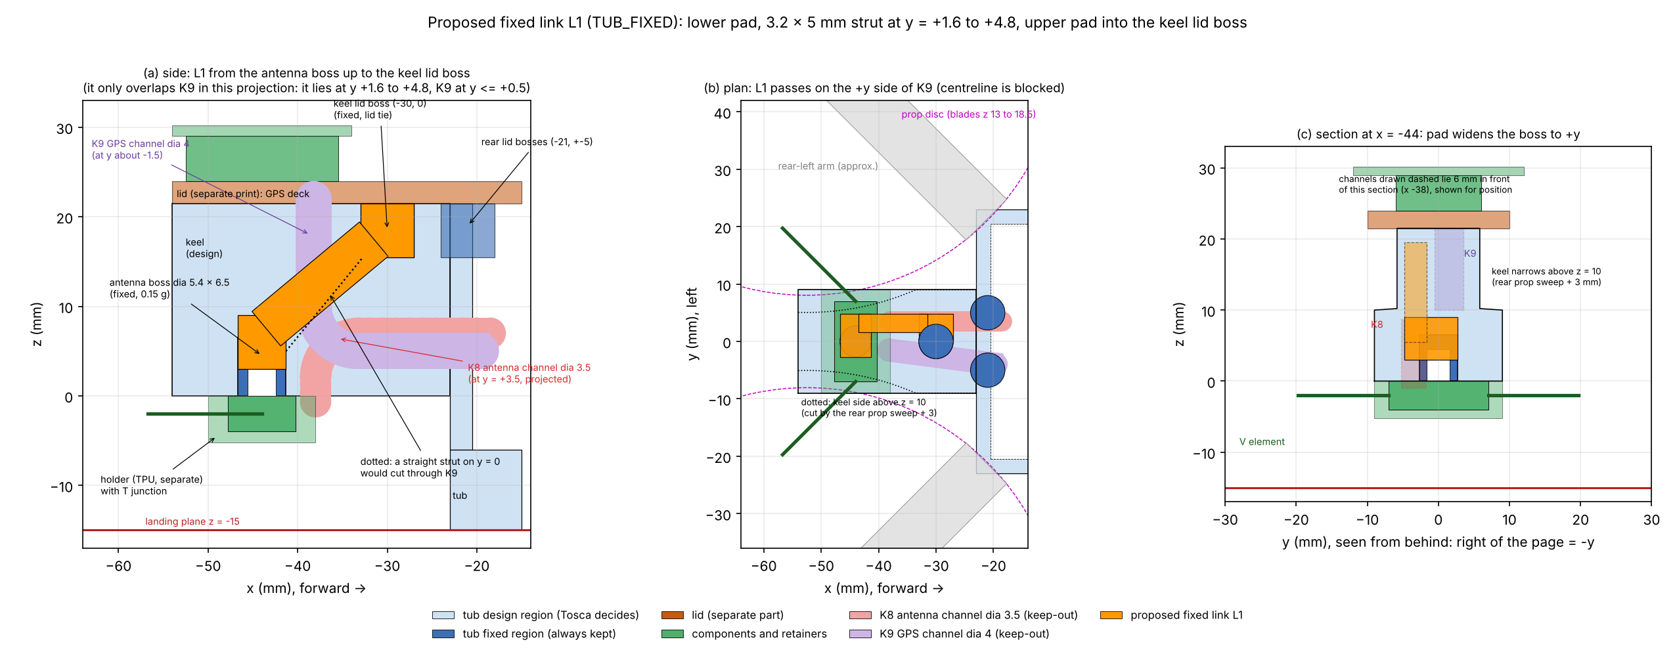
figures/f17_2_link.png
