migueldiaslima/drone-revB/figures/f17_3_antenna.png

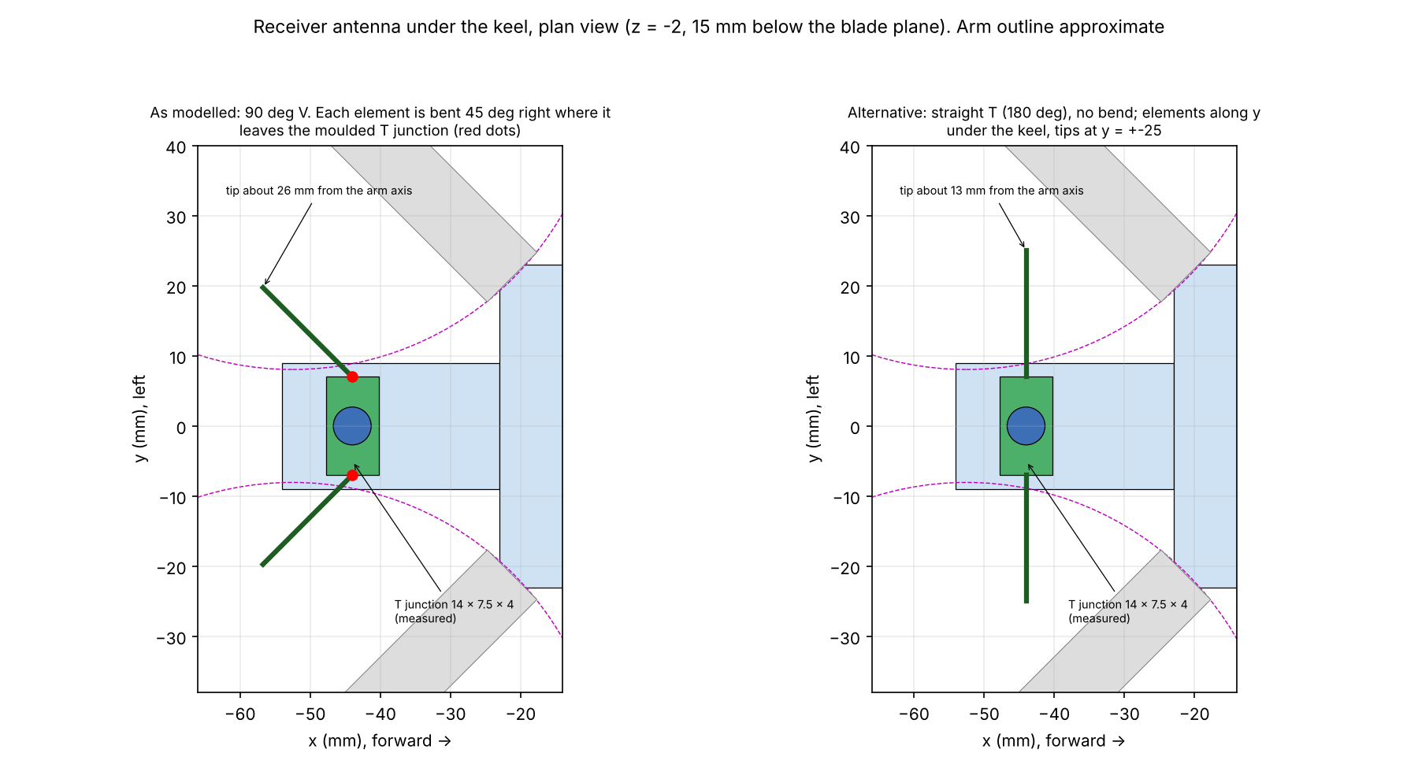
figures/f17_3_antenna.png
