migueldiaslima/drone-revB/figures/f17_4_conduit.png

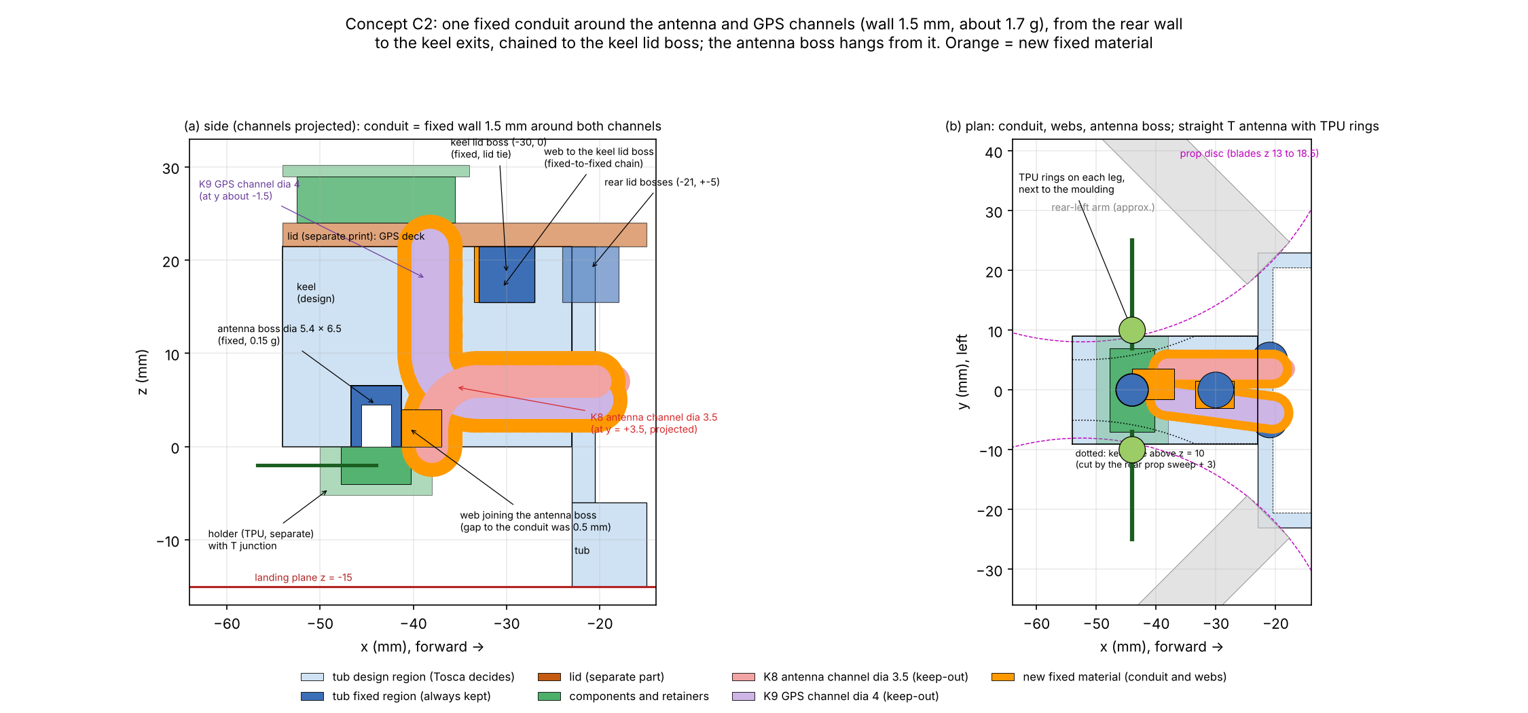
figures/f17_4_conduit.png
