migueldiaslima/drone-revB/figures/f17_5_seat_band.png

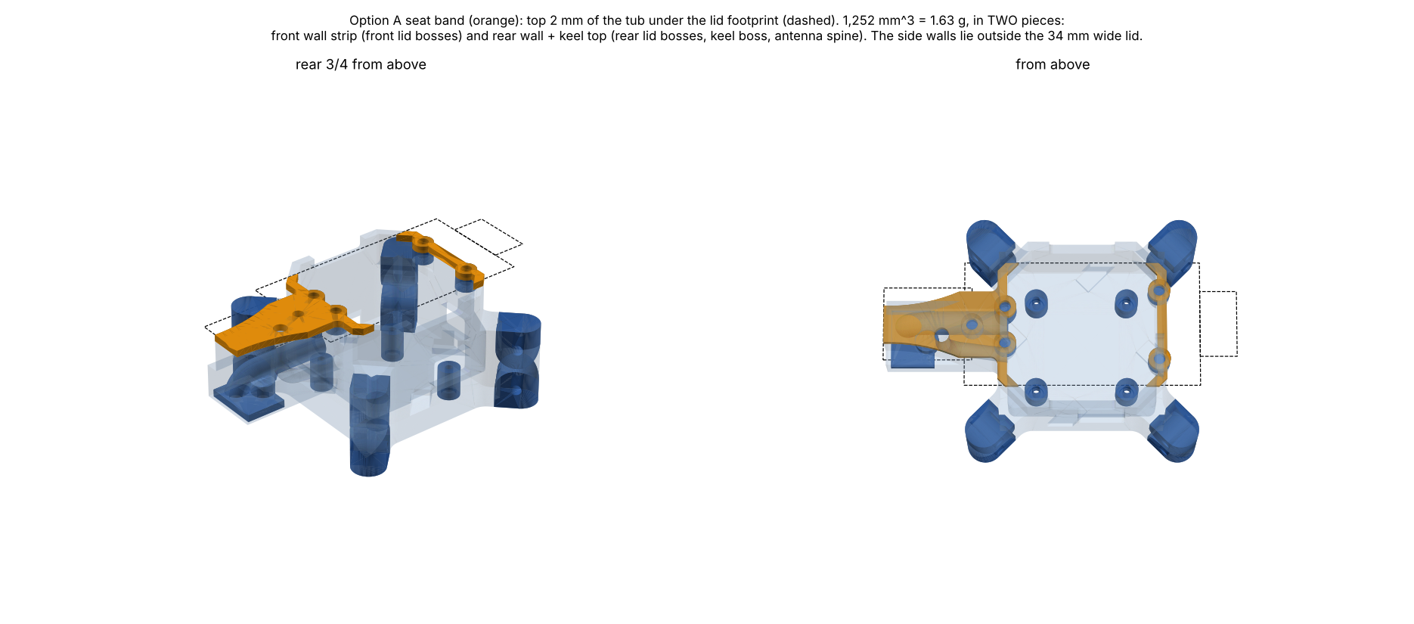
figures/f17_5_seat_band.png
