migueldiaslima/drone-revB/figures/f17_6_skid_section.png

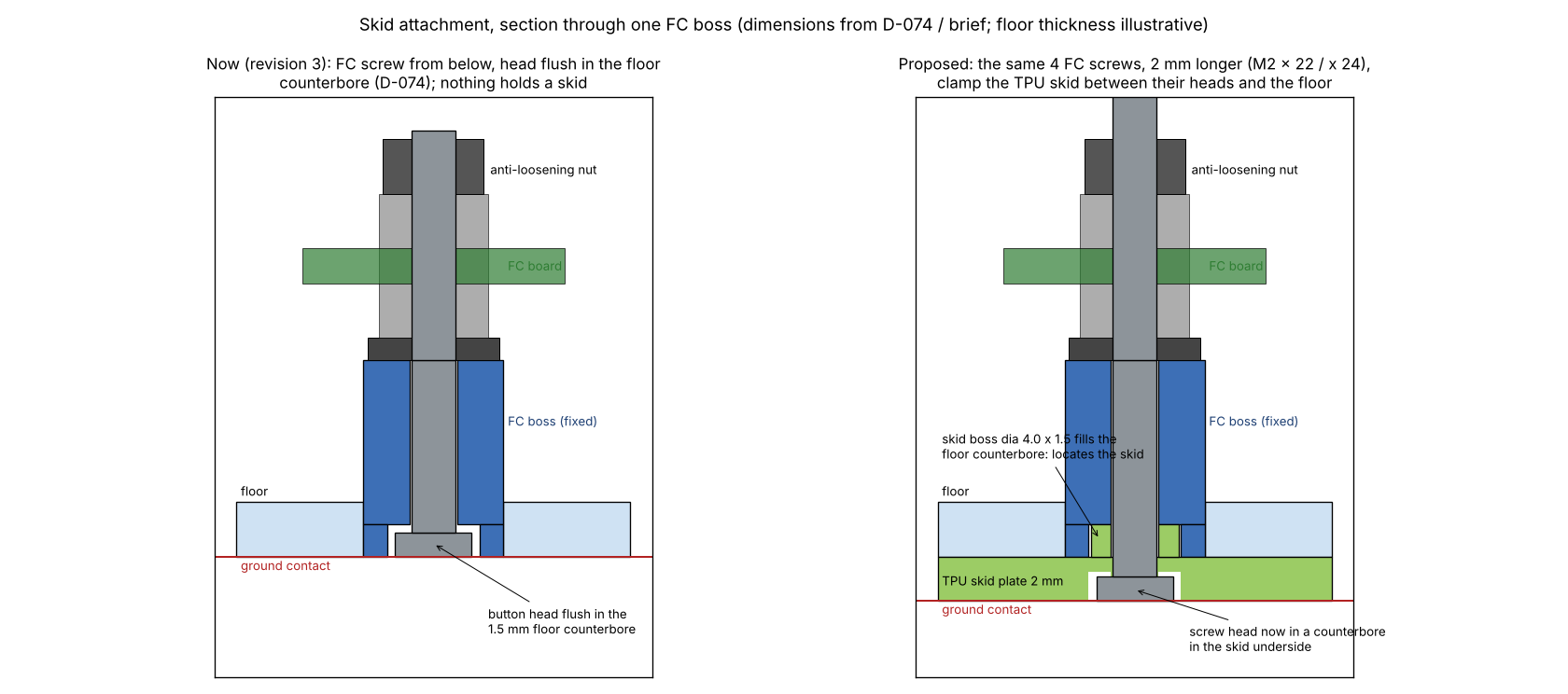
figures/f17_6_skid_section.png
