migueldiaslima/drone-revB/figures/fig06_v04B_export.png

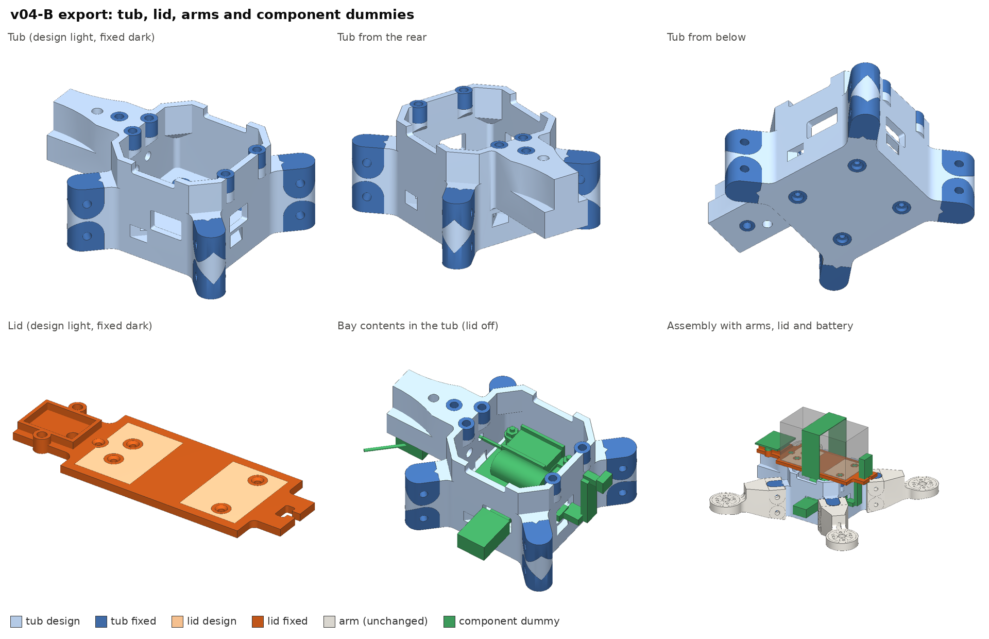
figures/fig06_v04B_export.png
