migueldiaslima/drone-revB/figures/fig_boss5_c31.png

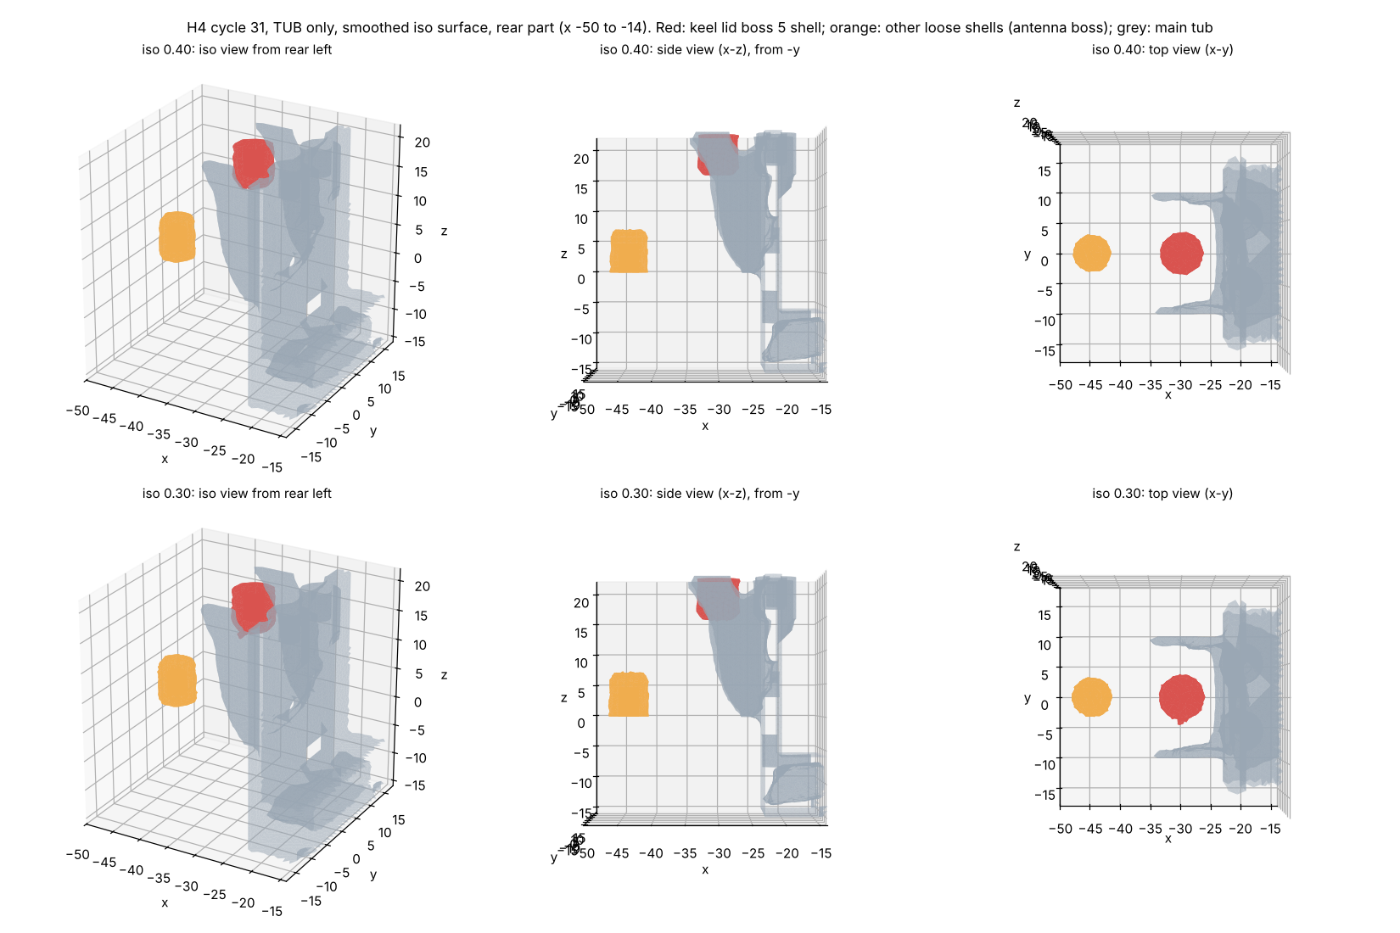
figures/fig_boss5_c31.png
