migueldiaslima/drone-revB/figures/fig_r4_deck_long.png

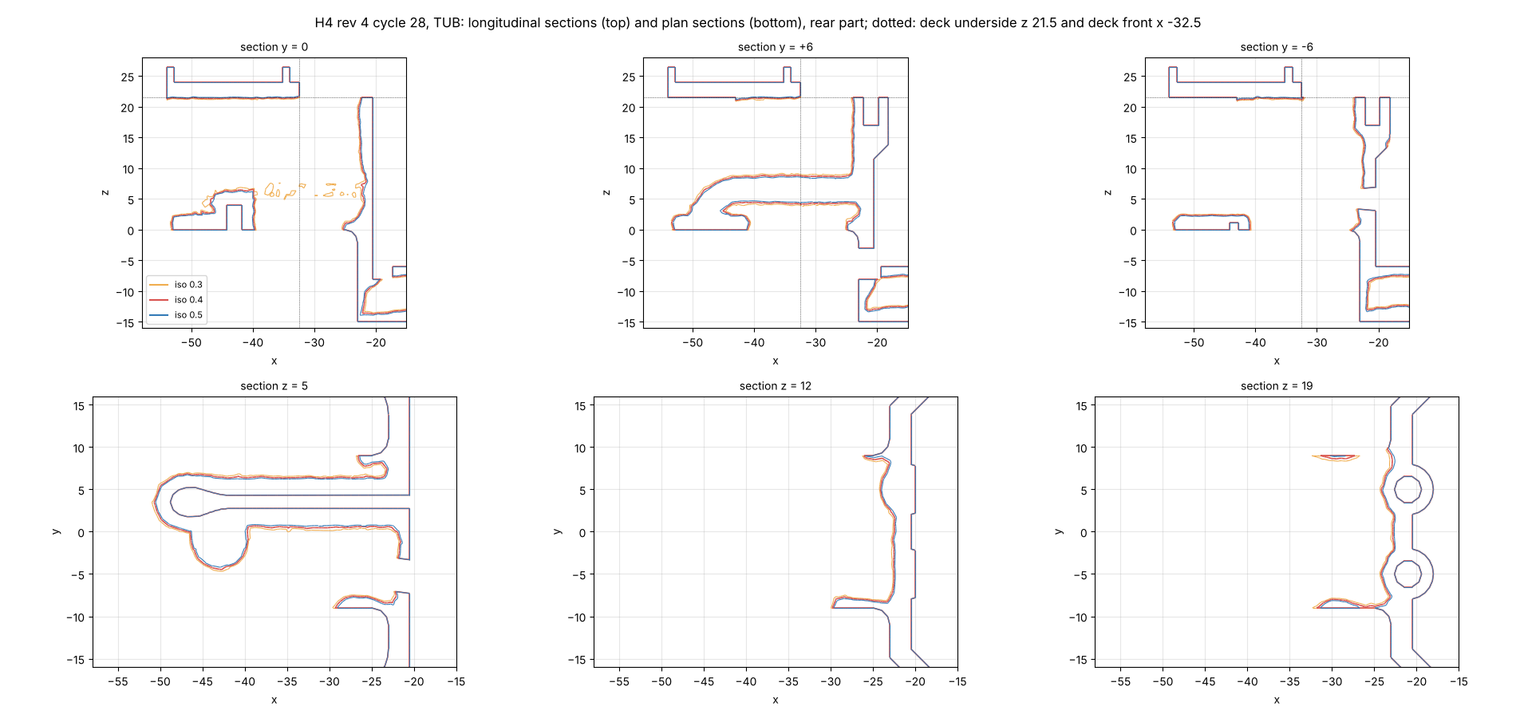
figures/fig_r4_deck_long.png
