migueldiaslima/drone-revB/figures/fig_t6_r4_ARM_pp.png

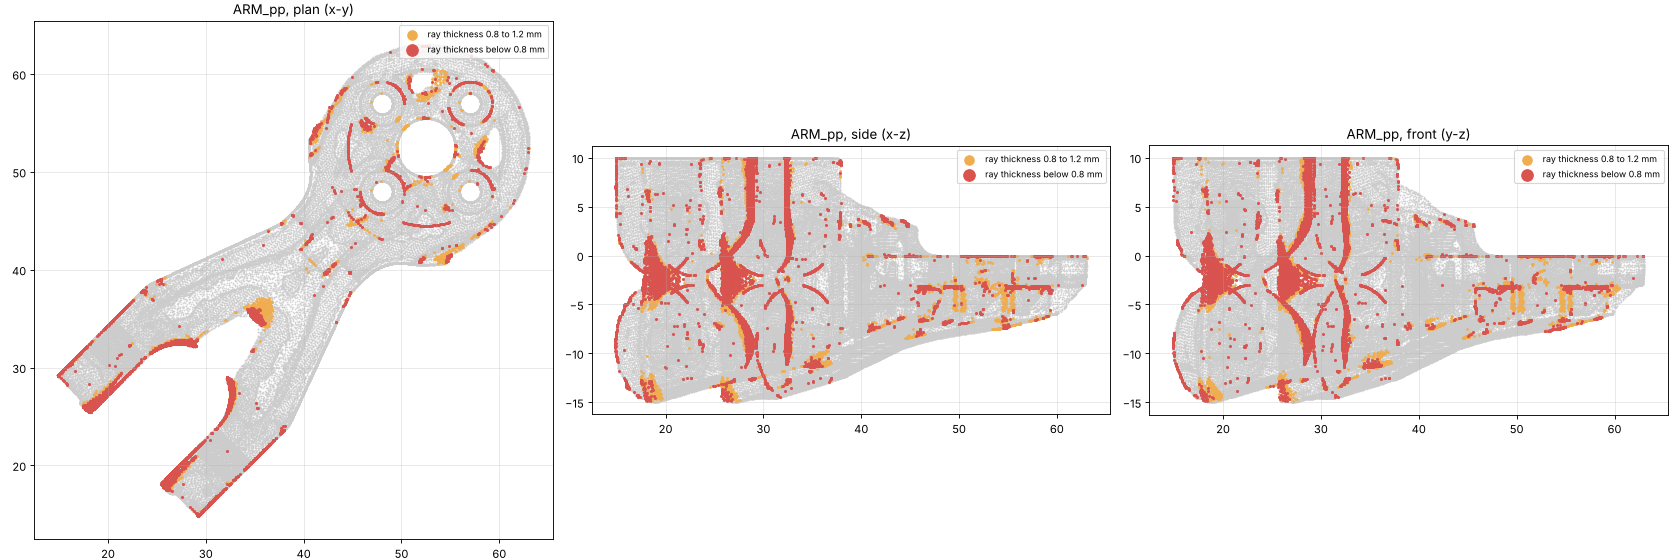
figures/fig_t6_r4_ARM_pp.png
