migueldiaslima/drone-revB/figures/fig_t6_r4_LID.png

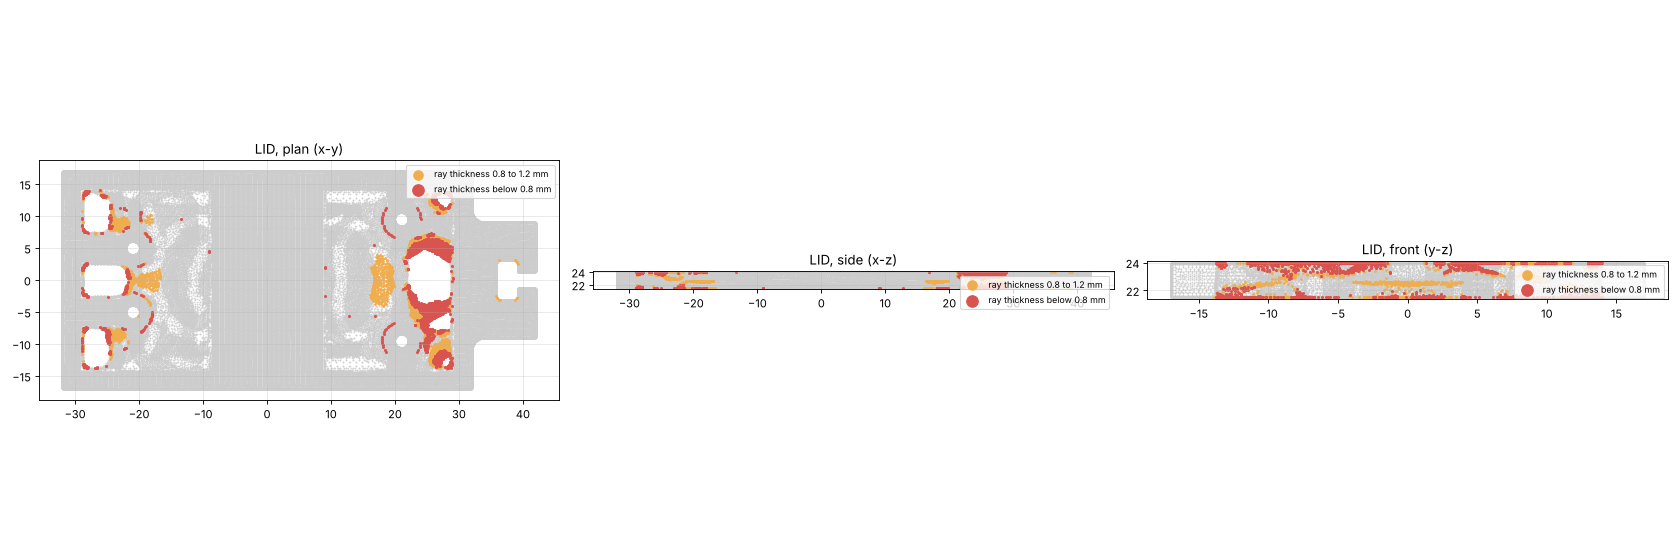
figures/fig_t6_r4_LID.png
