migueldiaslima/drone-revB/figures/fig_t6_r4_TUB.png

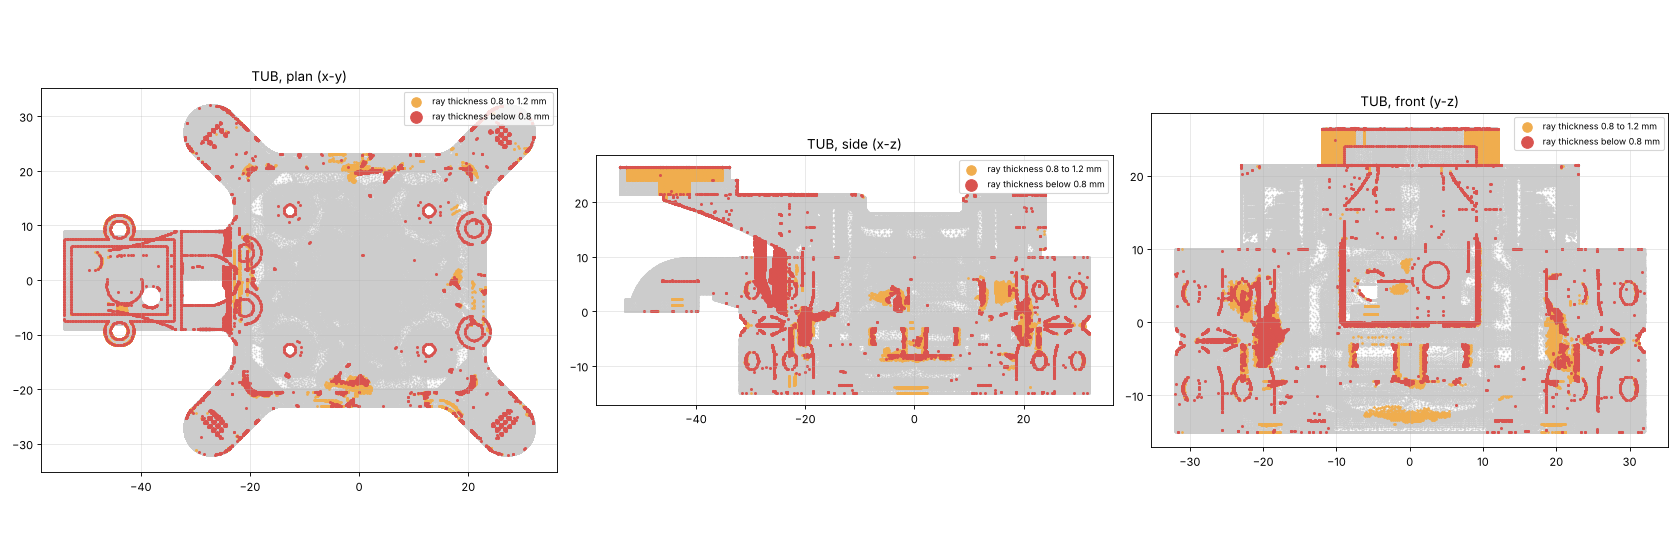
figures/fig_t6_r4_TUB.png
