migueldiaslima/drone-revB/figures/gps_cap_2_section_x44.png

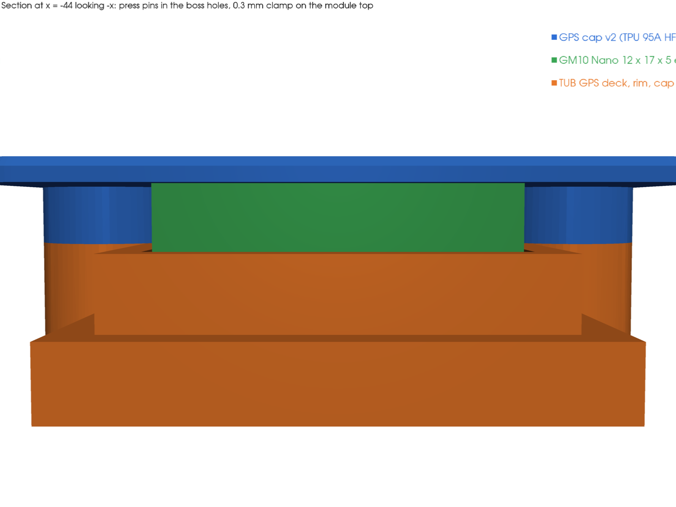
figures/gps_cap_2_section_x44.png
