migueldiaslima/drone-revB/figures/keels_r4_1_rear_below.png

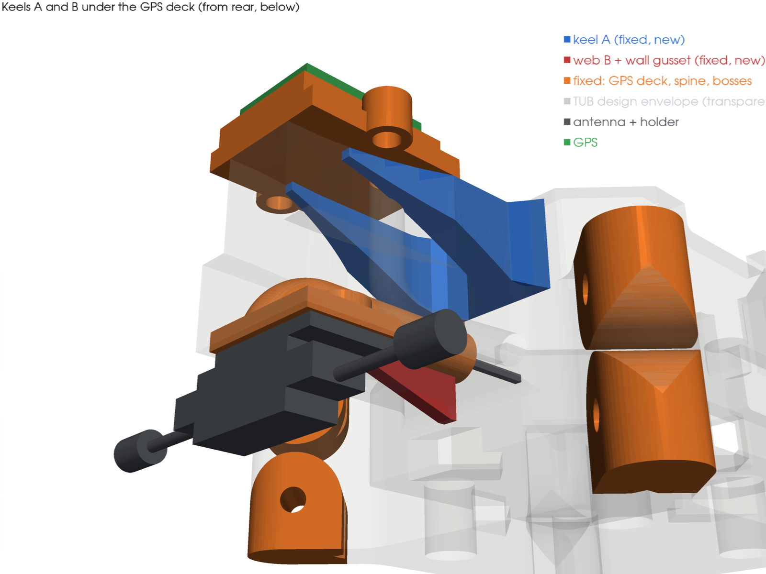
figures/keels_r4_1_rear_below.png
