migueldiaslima/drone-revB/figures/keels_r4_2_side.png

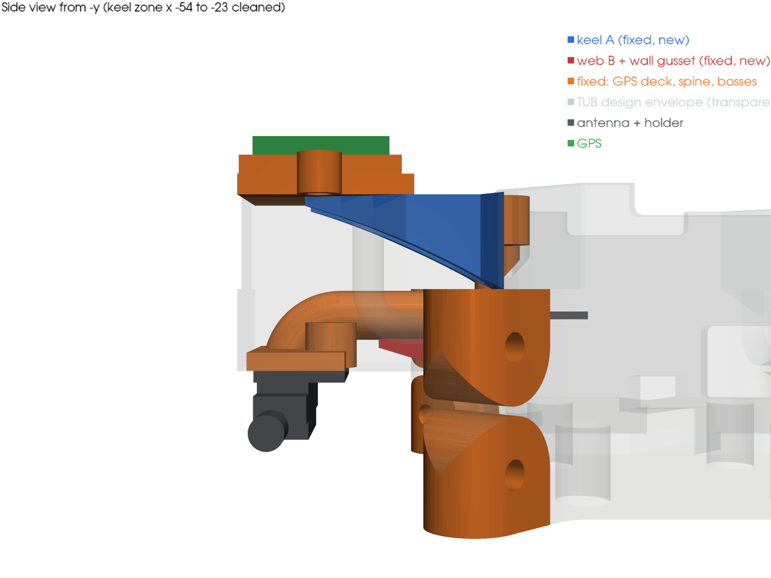
figures/keels_r4_2_side.png
