migueldiaslima/drone-revB/figures/keels_r4_3_rear_above.png

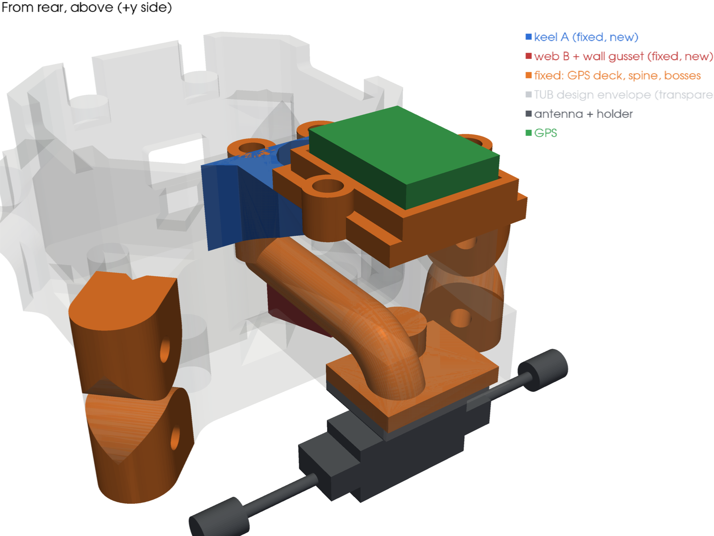
figures/keels_r4_3_rear_above.png
