migueldiaslima/drone-revB/figures/r4_render_2_no_battery.png

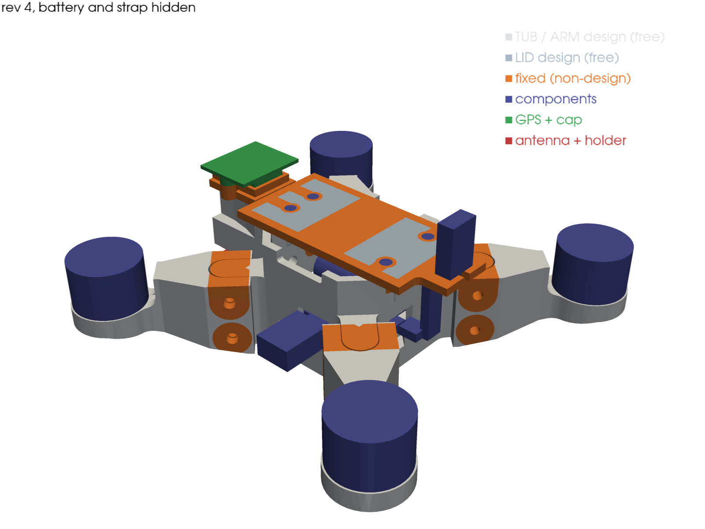
figures/r4_render_2_no_battery.png
