migueldiaslima/drone-revB/figures/r4_render_3_lid_raised.png

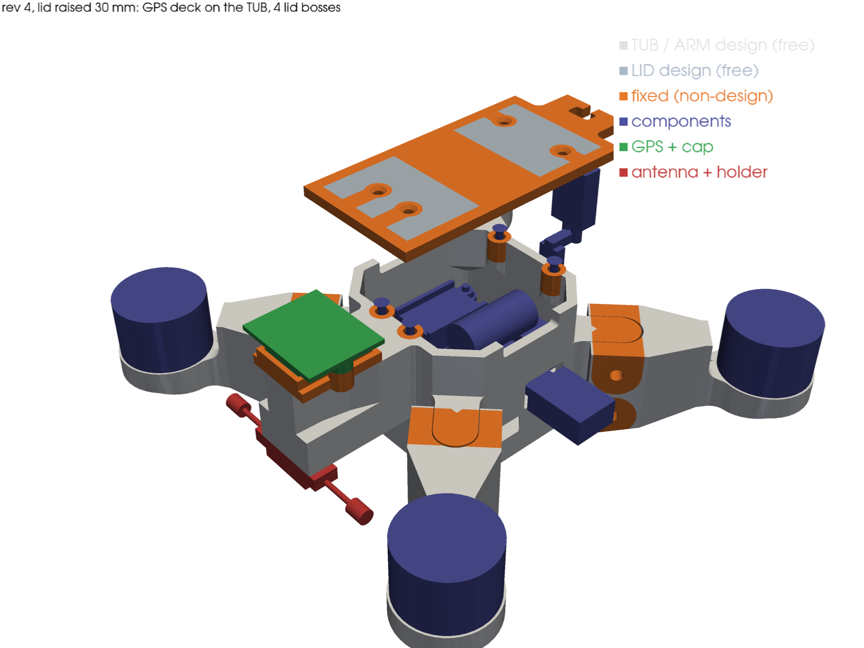
figures/r4_render_3_lid_raised.png
