migueldiaslima/drone-revB/figures/r4_render_4_rear_below.png

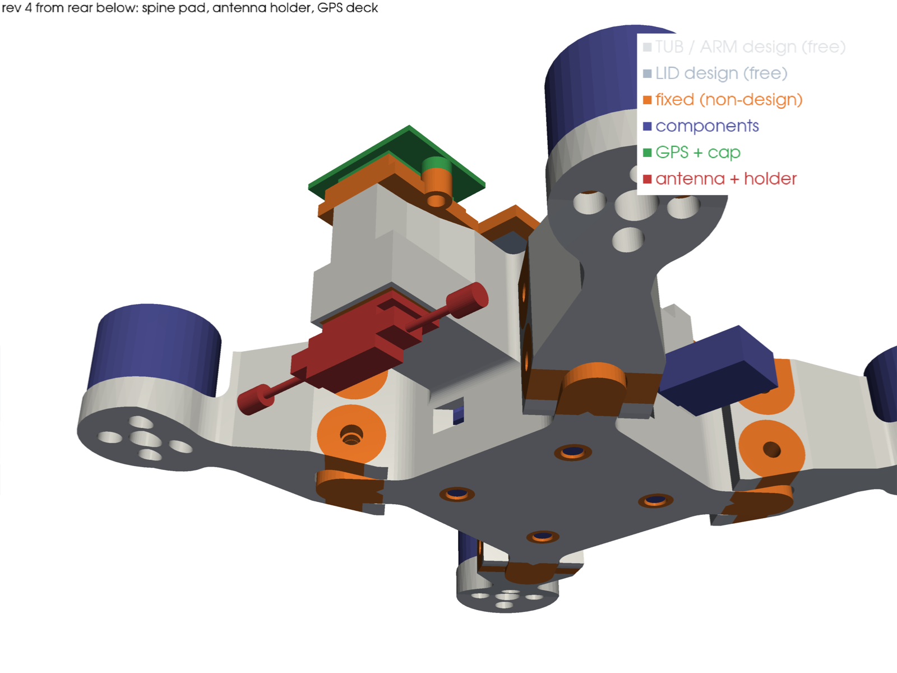
figures/r4_render_4_rear_below.png
