migueldiaslima/drone-revB/figures/r4_render_5_top.png

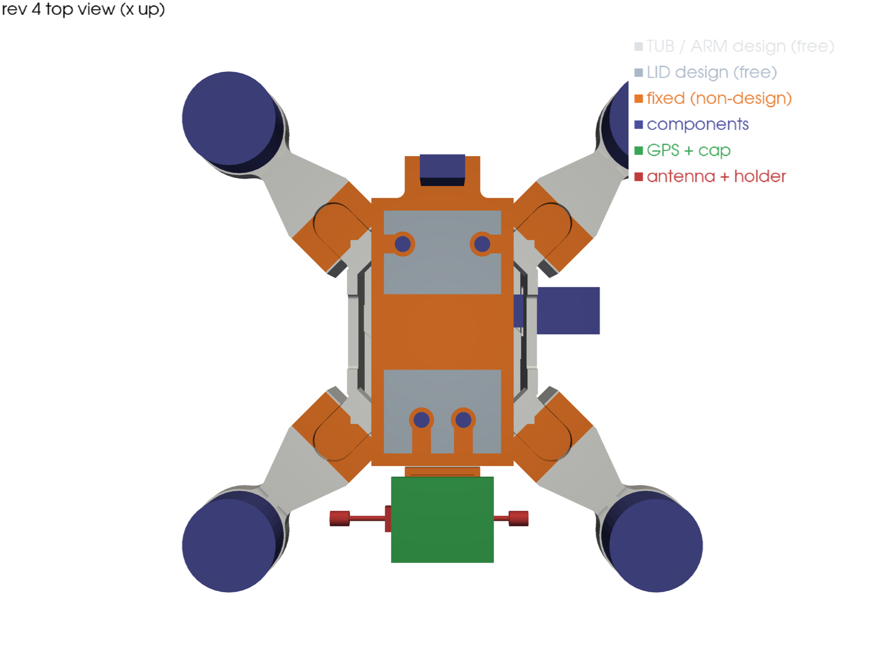
figures/r4_render_5_top.png
