migueldiaslima/drone-revB/figures/r4_render_6_fixed_xray.png

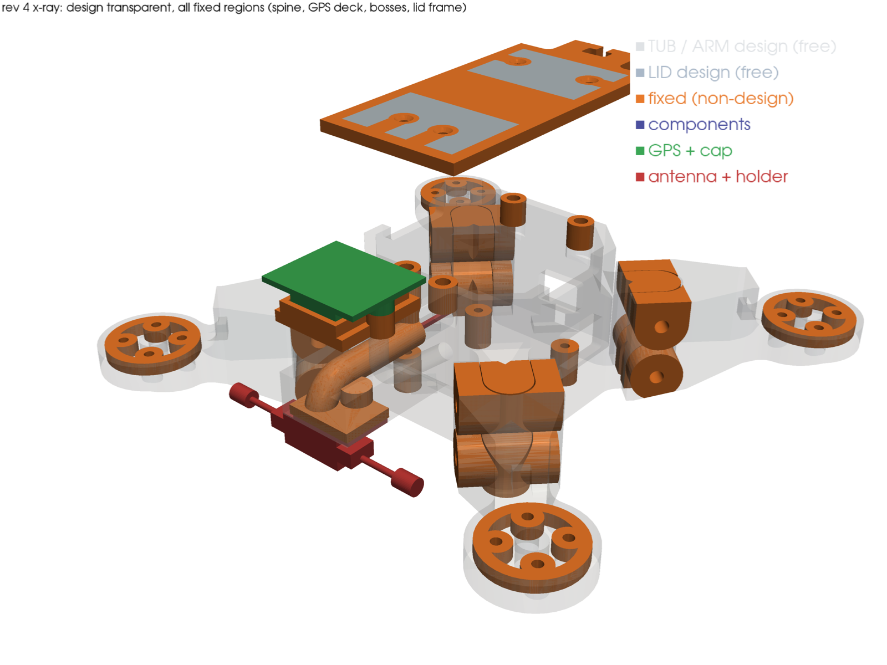
figures/r4_render_6_fixed_xray.png
