migueldiaslima/drone-revB/figures/rx_cradle_1_part.png

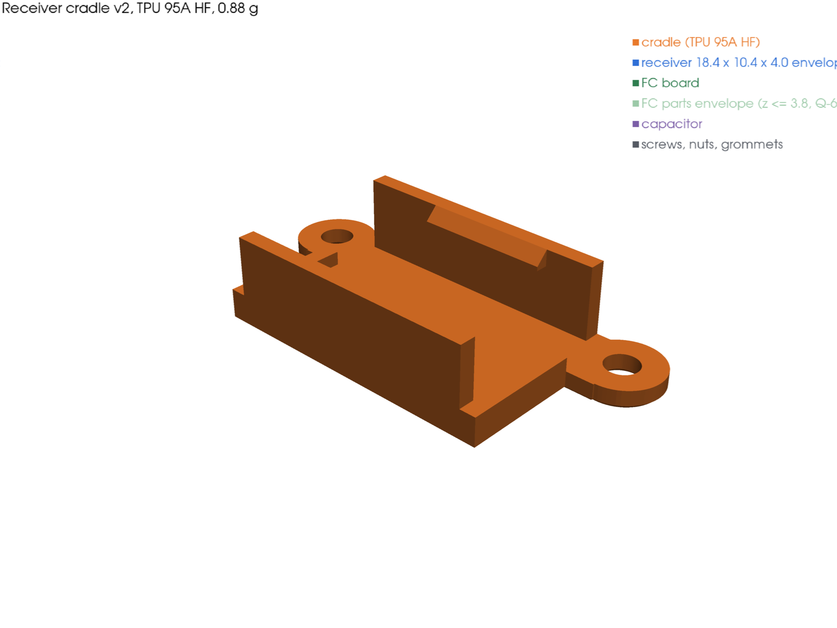
figures/rx_cradle_1_part.png
