migueldiaslima/drone-revB/figures/rx_cradle_3_section_x0.png

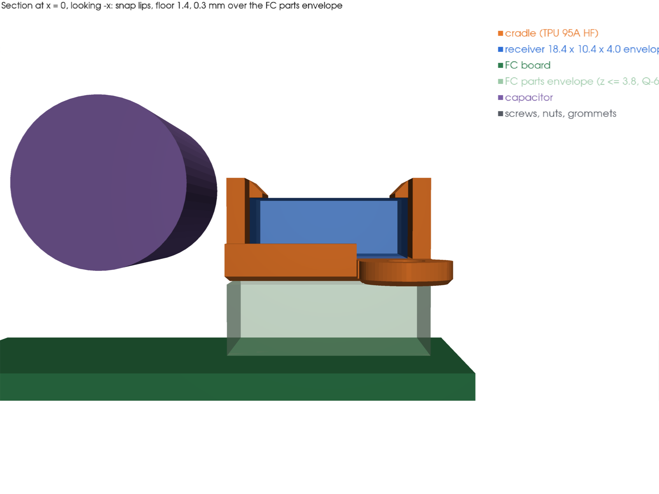
figures/rx_cradle_3_section_x0.png
