migueldiaslima/drone-revB/figures/rx_cradle_4_in_tub.png

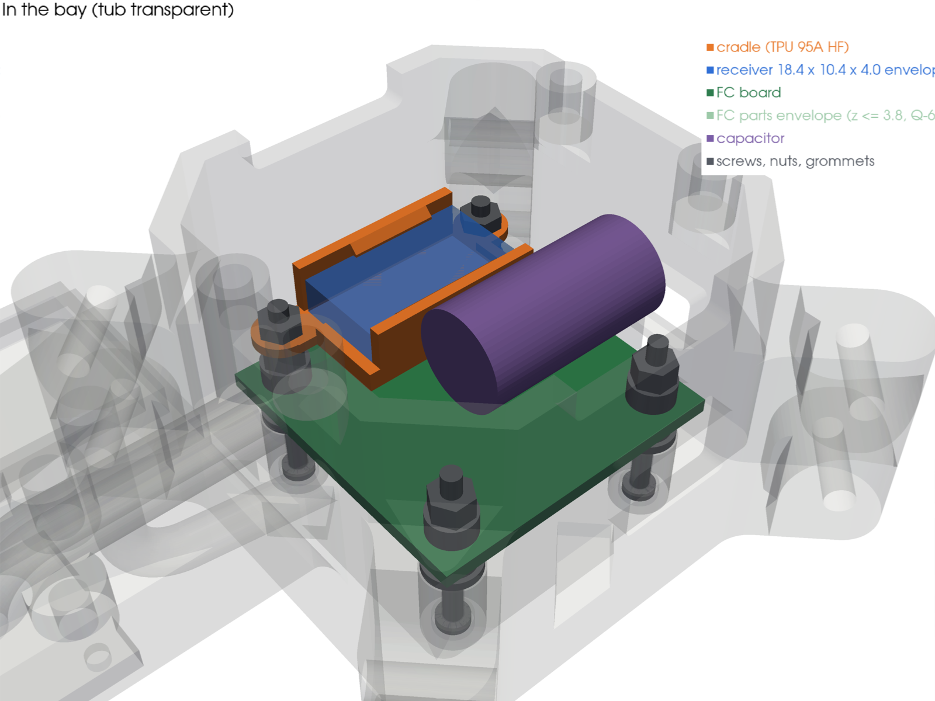
figures/rx_cradle_4_in_tub.png
