migueldiaslima/drone-revB/report/figures/su_deck_sections.png

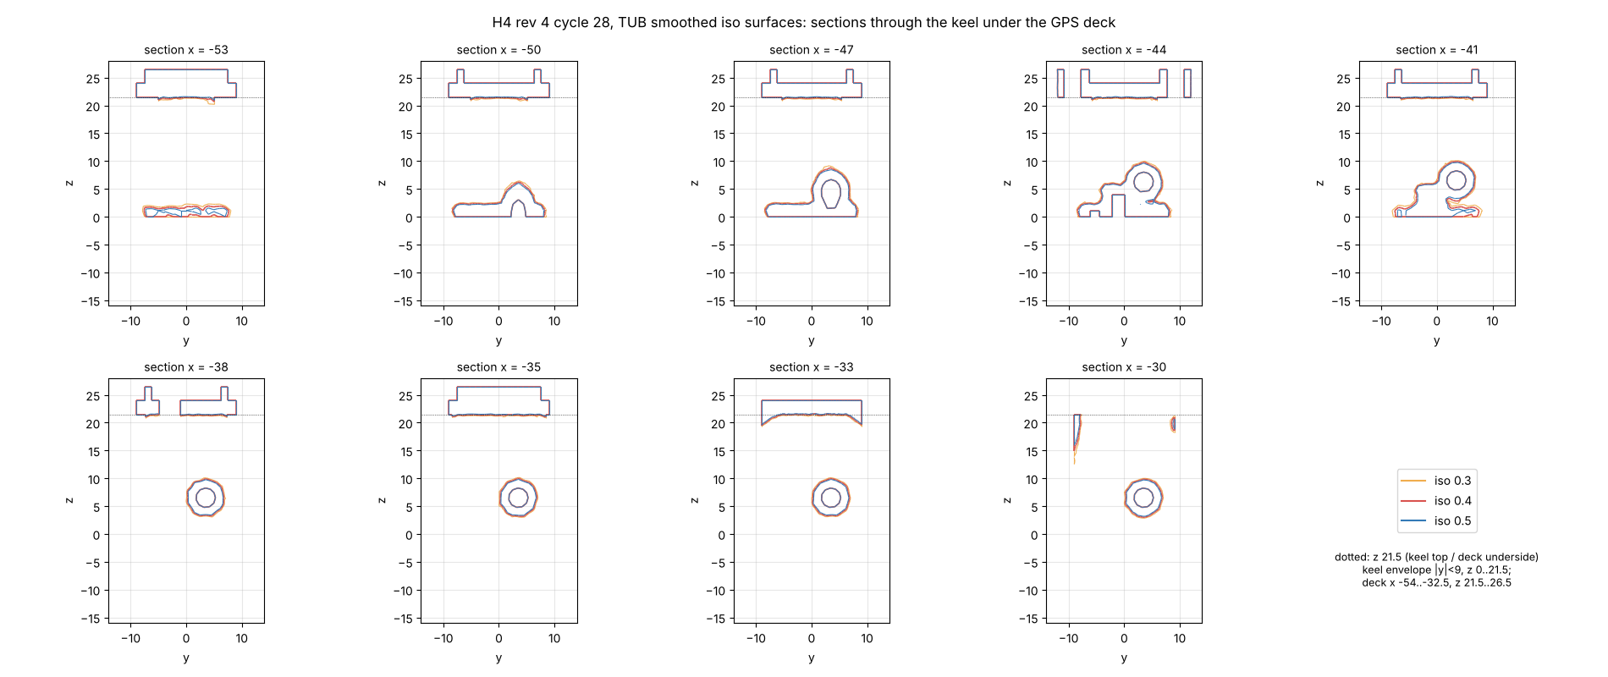
report/figures/su_deck_sections.png
