migueldiaslima/drone-revB/report/figures/su_keel_variants_3d.png

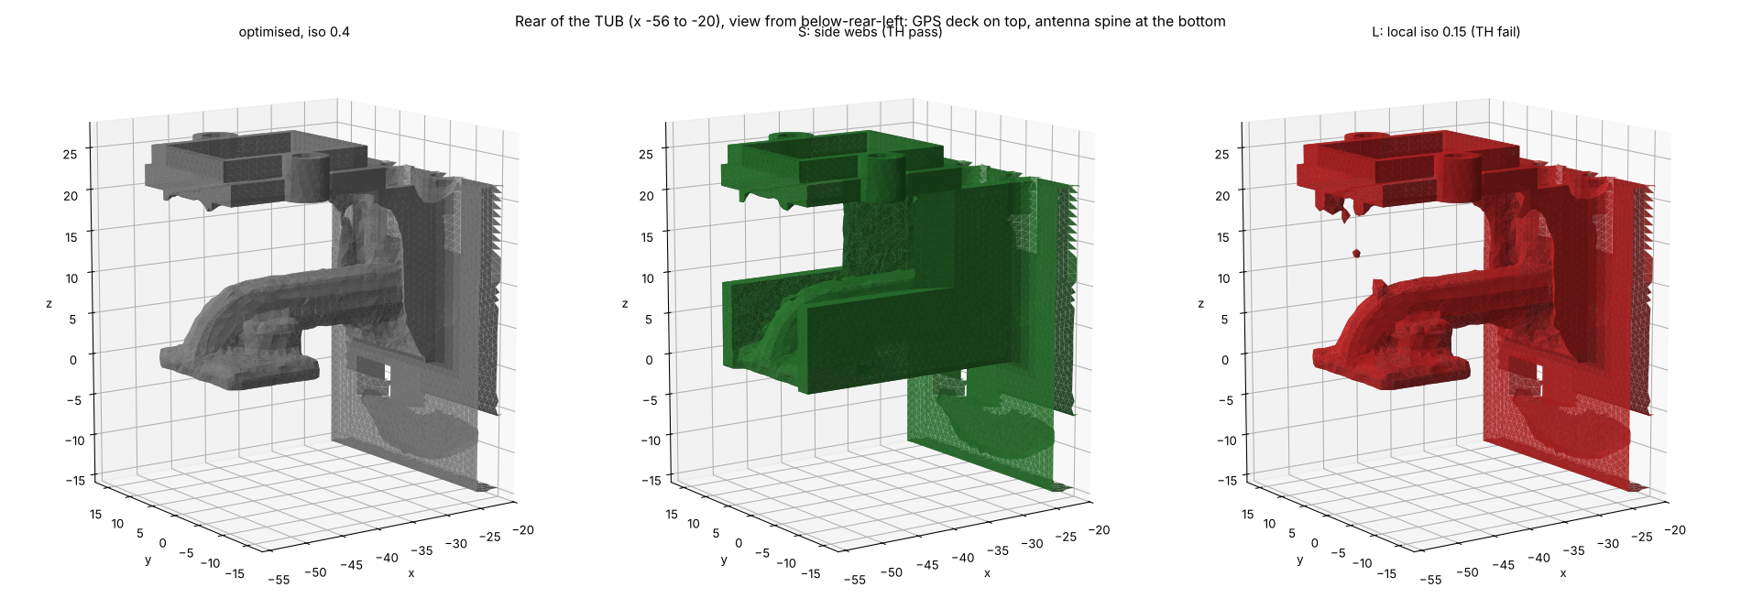
report/figures/su_keel_variants_3d.png
