migueldiaslima/drone-revB/report/figures/su_keel_variants_sections.png

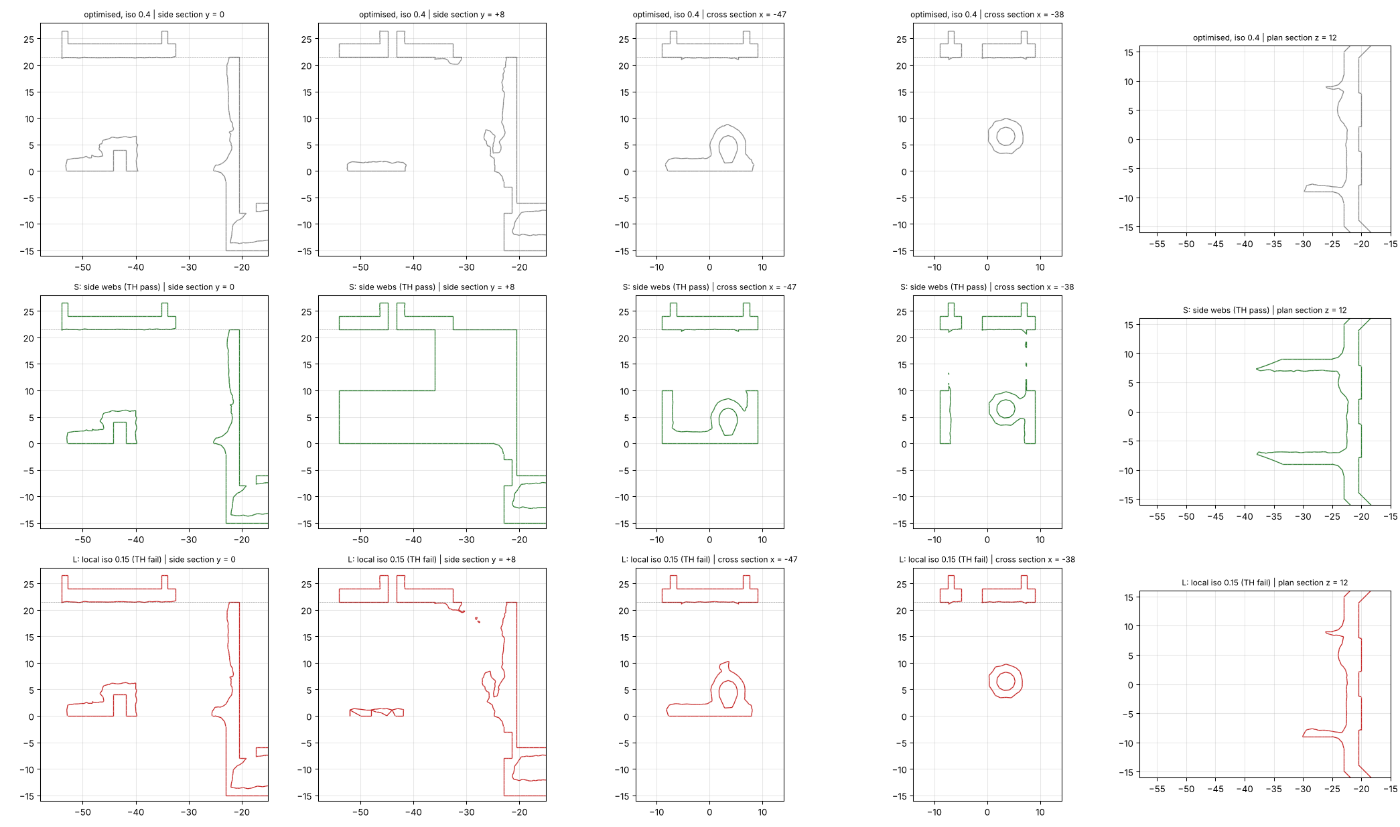
report/figures/su_keel_variants_sections.png
