migueldiaslima/drone-revB/report/figures/su_stage7_vm_LC3a.png

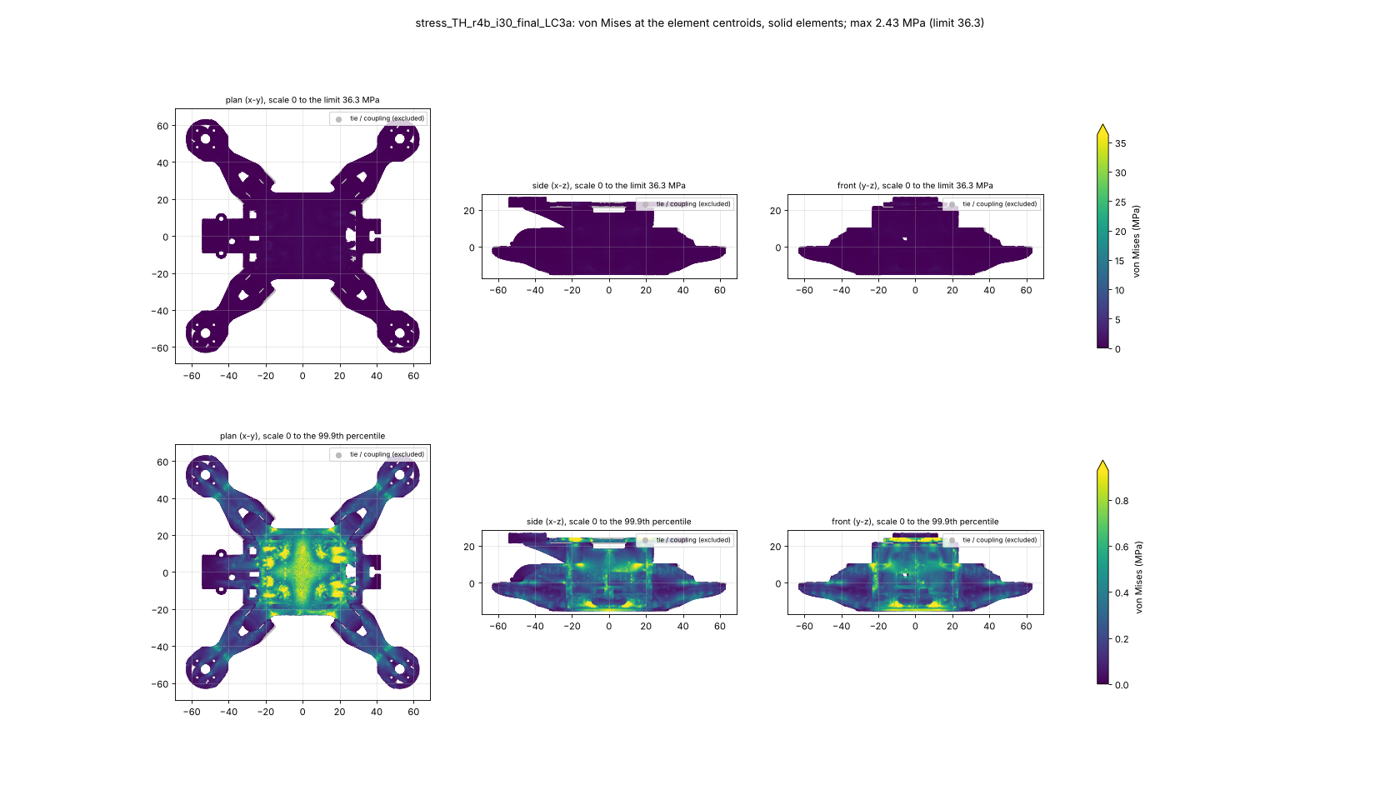
report/figures/su_stage7_vm_LC3a.png
