migueldiaslima/drone-revB/geometry/retainers/GPS_CAP_v2.step

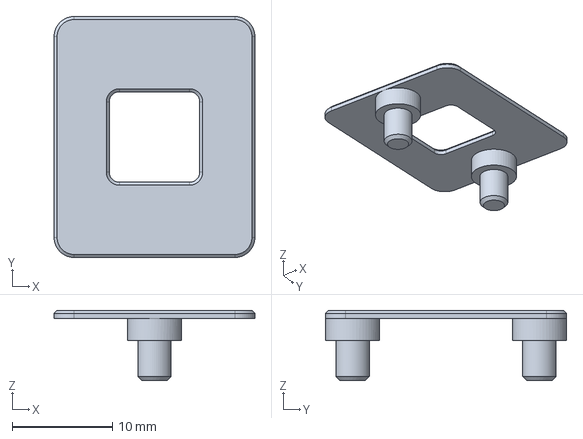
[picture p55: CAD file, 2026-10-13]
geometry/retainers/GPS_CAP_v2.step
20.0 x 24.0 x 7.00 mm
