migueldiaslima/drone-revB/geometry/v04B_r4/TUB.step

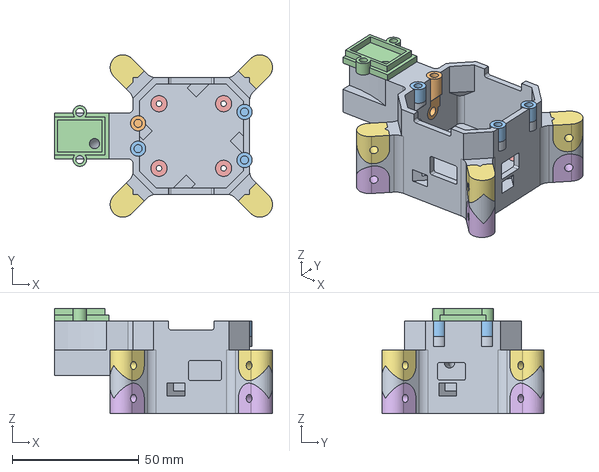
[picture p56: CAD file, 2026-10-13]
geometry/v04B_r4/TUB.step
86.0 x 64.1 x 41.5 mm
TUB_DESIGN
TUB_FIXED
