migueldiaslima/drone-revB/geometry/v04B_r4_keels/KEEL_B_r4.step

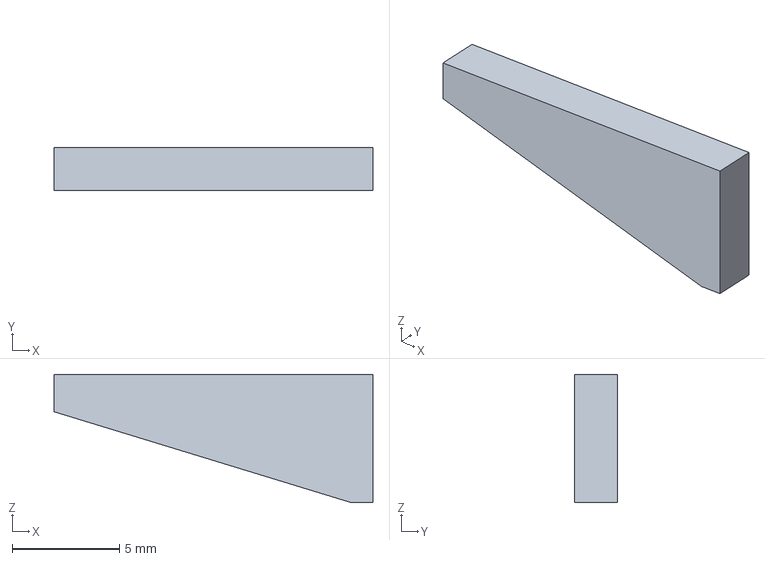
[picture p57: CAD file, 2026-10-13]
geometry/v04B_r4_keels/KEEL_B_r4.step
14.9 x 2.00 x 6.00 mm
