migueldiaslima/drone-revB/print/r4_iso030/print_ARM_pp_r4_iso030.stl

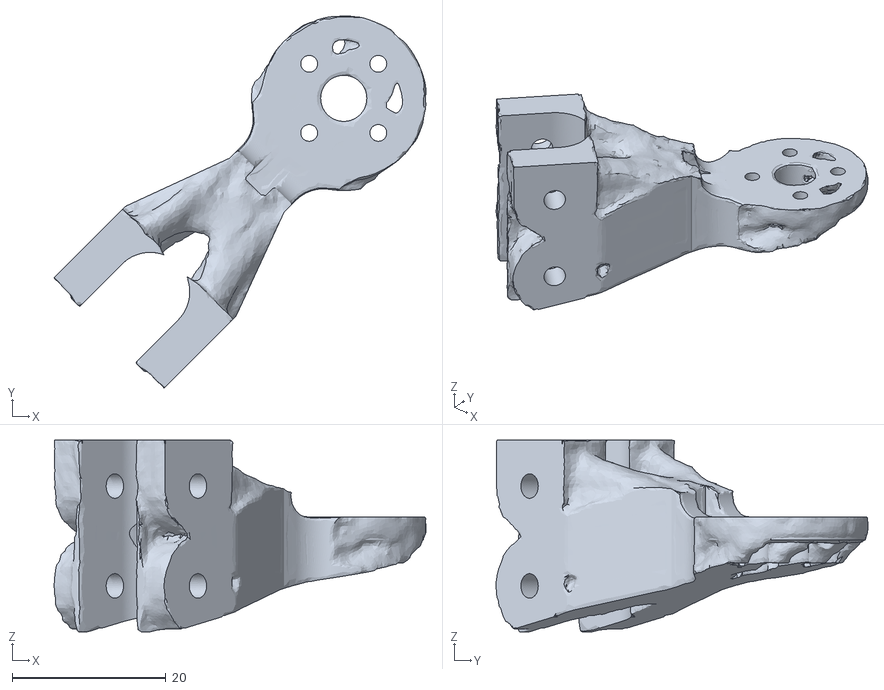
[picture p58: CAD file, 2026-10-14]
print/r4_iso030/print_ARM_pp_r4_iso030.stl
48.4 x 48.4 x 25.0
