migueldiaslima/drone-revB/scripts/hpc/TH04/keels/KEEL_A_r4.stl

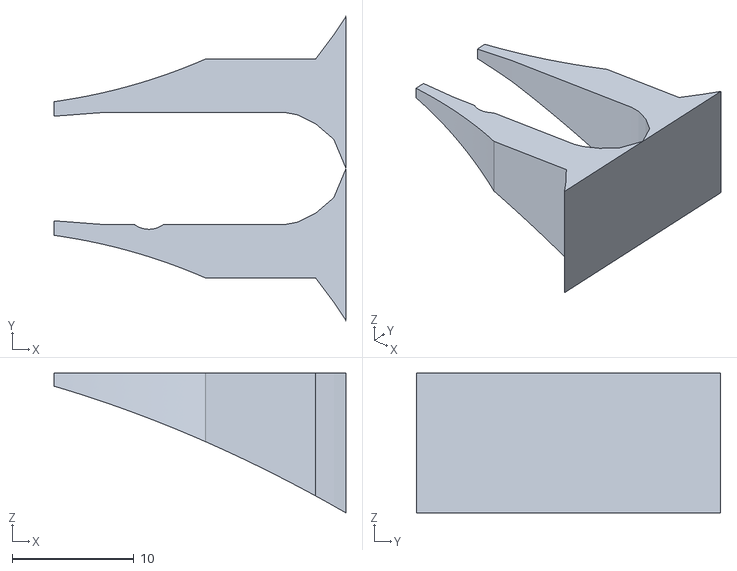
[picture p59: CAD file, 2026-10-13]
scripts/hpc/TH04/keels/KEEL_A_r4.stl
24.0 x 25.0 x 11.5
