migueldiaslima/drone-revB/geometry/retainers/RX_CRADLE_v2.step

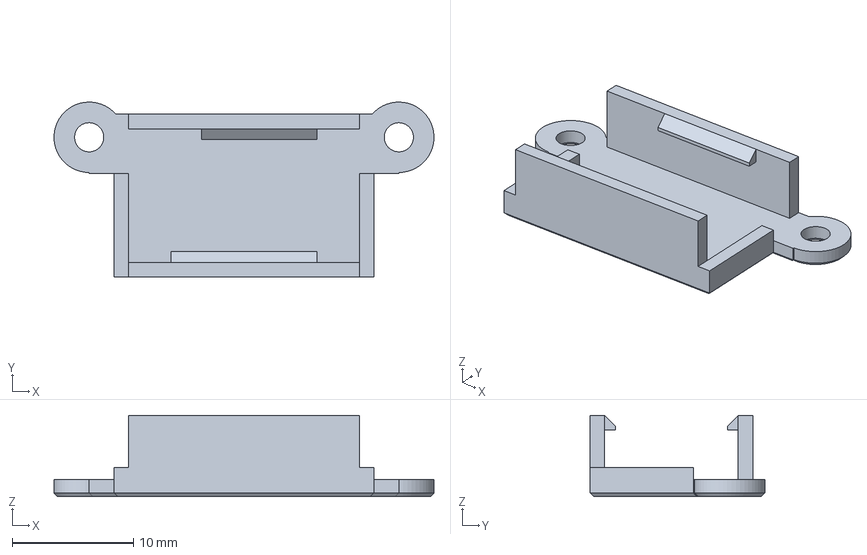
[picture p60: CAD file, 2026-10-13]
geometry/retainers/RX_CRADLE_v2.step
31.3 x 14.4 x 6.70 mm
