migueldiaslima/drone-revB/geometry/v04B_r4/ARM_pm.step

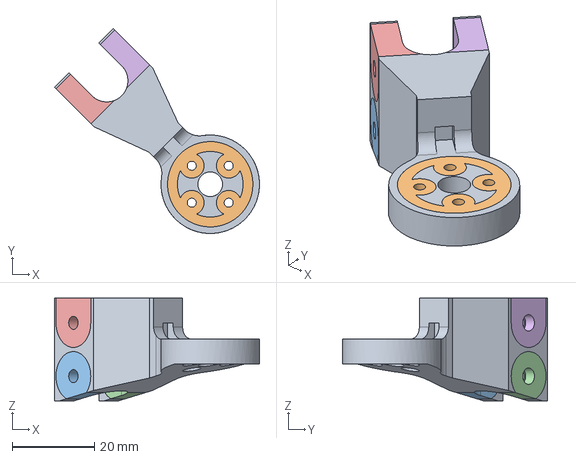
[picture p61: CAD file, 2026-10-13]
geometry/v04B_r4/ARM_pm.step
49.9 x 49.9 x 25.0 mm
ARM_DESIGN
ARM_FIXED
