migueldiaslima/drone-revB/geometry/v04B_r4_keels/KEEL_ZONE_r4.step

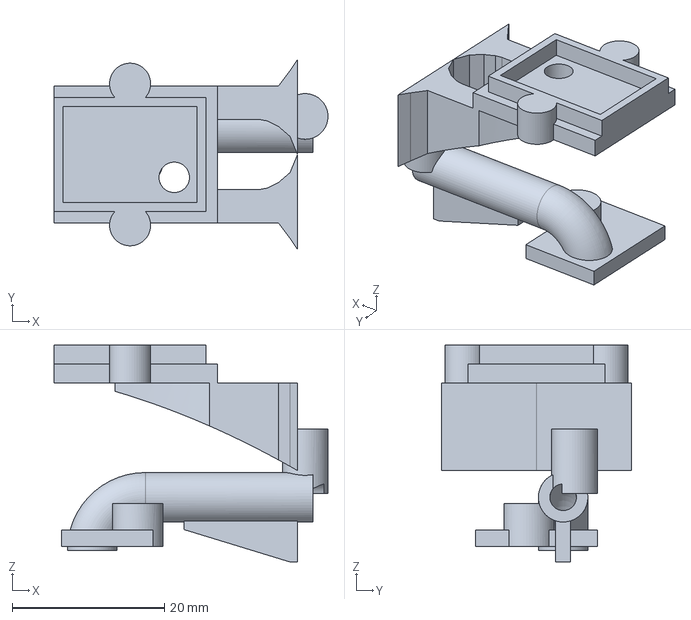
[picture p62: CAD file, 2026-10-13]
geometry/v04B_r4_keels/KEEL_ZONE_r4.step
36.0 x 25.0 x 28.5 mm
