migueldiaslima/drone-revB/print/r4_iso030/print_LID_r4_iso030.stl

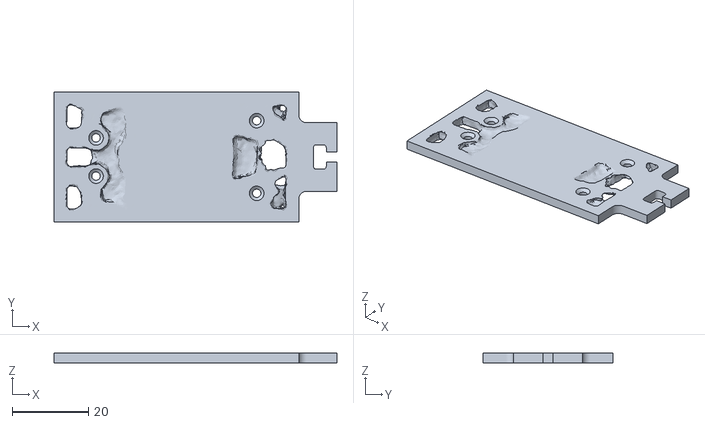
[picture p63: CAD file, 2026-10-14]
print/r4_iso030/print_LID_r4_iso030.stl
74.0 x 34.0 x 2.50
