migueldiaslima/drone-revB/geometry/v04B_r4/KEEPOUTS_v04B.step

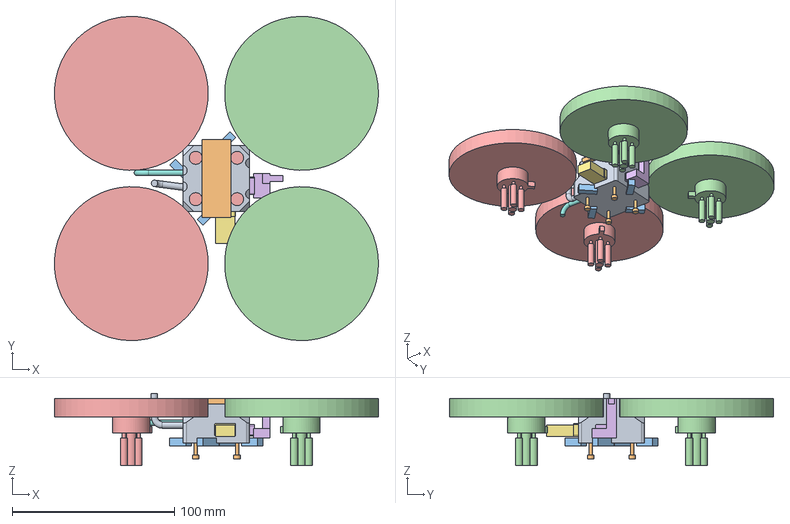
[picture p64: CAD file, 2026-10-13]
geometry/v04B_r4/KEEPOUTS_v04B.step
199.8 x 199.8 x 44.5 mm
K1_fc_bay
K3_fc_screw_holes
K4_components_above_fc
K5_nut_columns
K6_pigtail
K7_usb
K8_antenna_channel
K9_gps_channel
K10_strap_passage
K11_motor_lead_passages
K12_props_motors_arm_clearances
