migueldiaslima/drone-revB/geometry/v04B_r4/COMPONENTS_v04B.step

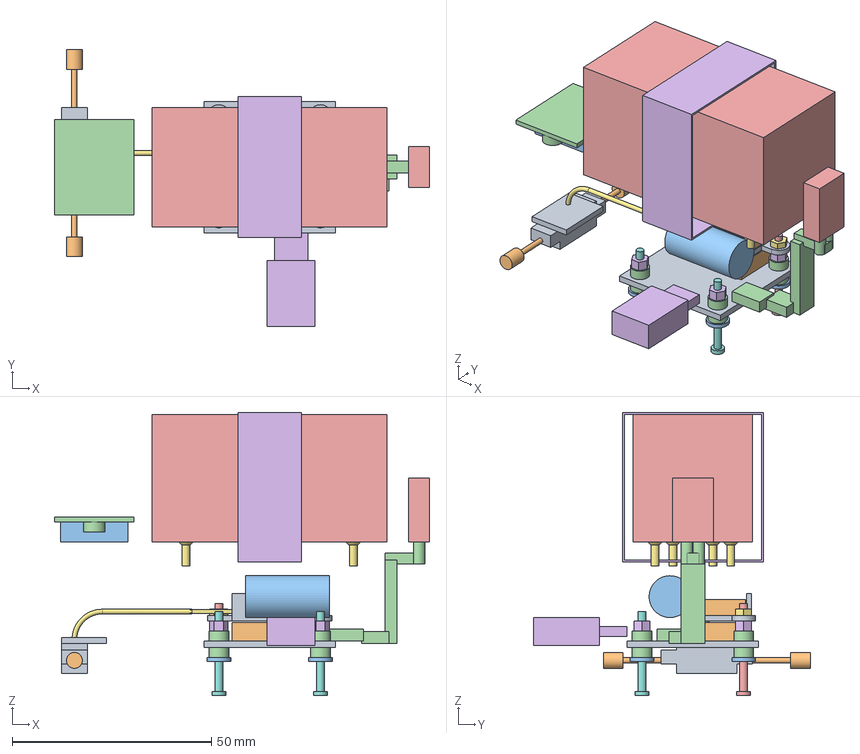
[picture p65: CAD file, 2026-10-13]
geometry/v04B_r4/COMPONENTS_v04B.step
94.1 x 69.5 x 71.1 mm
fc_board
fc_heatsink_and_parts_under_cradle_max
damping_ring_pp
grommet_pp
screw_pp
nut_lock_pp
nut_nylon_pp
damping_ring_pm
grommet_pm
screw_pm
nut_lock_pm
damping_ring_mp
grommet_mp
screw_mp
nut_lock_mp
nut_nylon_mp
damping_ring_mm
grommet_mm
screw_mm
nut_lock_mm
receiver_cradle
receiver
capacitor
pigtail
xt30_female_on_tab
usb_plug
antenna_coax
antenna_junction
antenna_holder
antenna_V
gps_module
gps_cap
battery
strap
lid_screw_1
lid_screw_2
lid_screw_3
lid_screw_4
