migueldiaslima/drone-revB/geometry/v04B_r4/LID.step

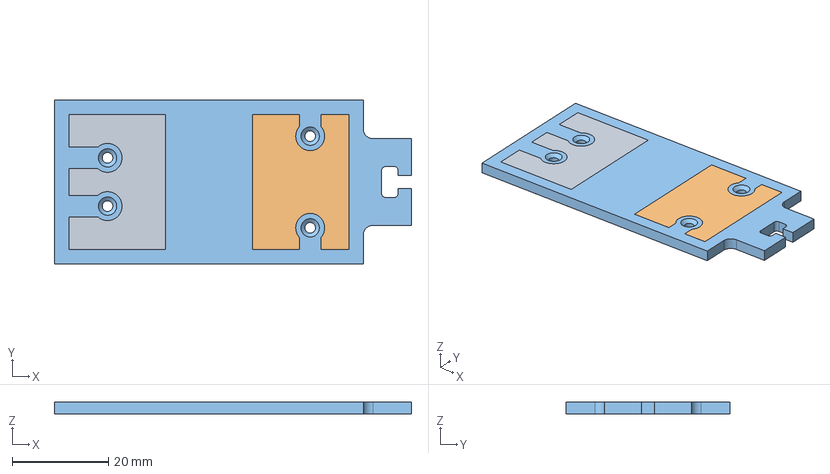
[picture p66: CAD file, 2026-10-13]
geometry/v04B_r4/LID.step
74.0 x 34.0 x 2.50 mm
LID_DESIGN
LID_FIXED
