migueldiaslima/drone-revB/(list of files, cad)

Other CAD files:
scripts/hpc/TH04/keels/KEEL_B_r4.stl
geometry/v04B_r4_keels/KEEL_A_r4.step
geometry/v04B_r4/ARM_mm.step
geometry/v04B_r4/ARM_mp.step
geometry/v04B_r4/ARM_pp.step
geometry/v03B_arms/ARM_pp.step
geometry/v03B_arms/ARM_mm.step
geometry/v03B_arms/ARM_mp.step
geometry/v03B_arms/ARM_pm.step
geometry/v04B/ARM_mm.step
geometry/v04B/ARM_mp.step
geometry/v04B/ARM_pm.step
geometry/v04B/ARM_pp.step
geometry/v04B/COMPONENTS_v04B.step
geometry/v04B/KEEPOUTS_v04B.step
geometry/v04B/LID.step
geometry/v04B/TUB.step
geometry/v04B_r3/ARM_mm.step
geometry/v04B_r3/ARM_mp.step
geometry/v04B_r3/ARM_pm.step
geometry/v04B_r3/ARM_pp.step
geometry/v04B_r3/COMPONENTS_v04B.step
geometry/v04B_r3/KEEPOUTS_v04B.step
geometry/v04B_r3/LID.step
geometry/v04B_r3/TUB.step
