migueldiaslima/drone-revB/print/r4_iso030/README.md

# Print set v04-B rev 4, iso 0.3 (build log items 62, 63, 69)

Model coordinates (mm, z up, origin at the frame centre, z = 0 on the arm top). Restoration of H4 rev 4 cycle 28 at
iso 0.3 with the exact fixed solids and keels A + B (D-044, D-087, DV-27); checked against the STEP geometry: every
exact feature present, no material in any hole, slot or seat (0.000 mm^3 either way).

| File | Content | Volume | Mass (1.30e-3 g/mm^3) |
|---|---|---|---|
| print_TUB_r4_iso030.stl | TUB, one closed piece | 36,318.1 mm^3 | 47.21 g |
| print_LID_r4_iso030.stl | LID, one closed piece | 5,087.6 mm^3 | 6.61 g |
| print_ARM_pp_r4_iso030.stl | arm in the pp corner (print 4; rotate 90 / 180 / 270 deg about z for pm, mm, mp) | 6,811.1 mm^3 | 8.85 g |
| assembly_r4_iso030.stl | TUB + LID + 4 arms in place (viewing and renders only; touching faces overlap, not for slicing) | | 89.22 g frame |
