migueldiaslima/drone-revB/docs/report_figures_setup.md

# Report figures from the set-up chat: inventory

Set-up chat, 2026-10-14. Status: **exists** (in `figures/`, script in `scripts/figures/`), **here** (can be produced in the set-up workspace from files already on hand, no nexus), **nexus** (needs a short run on nexus by Miguel, then plotting here). Times are working time including checks; nexus times are for Miguel's part plus a download. All figures are matplotlib PNG unless stated; data for redrawing in one style is in `data/report/`.

## Optimisation and verification

| # | Figure | Content | Source | Status | Time |
|---|---|---|---|---|---|
| 1 | Optimisation history | volume, f7 to f12 and SE/cap per load case against cycle (H4 rev 4, cycles 0 to 28; overshoot at 15 to 22) | `data/report/h4r4_history.csv` | data exists; plot here (or redraw by the main chat) | 10 min |
| 2 | TH comparison | f7 and max SE/cap of Tosca c28 and the eight TH models (no keels fail at 146.8 Hz, keel variants, final PASS) | `data/report/th_comparison.csv` | data exists; plot here | 10 min |
| 3 | Density / iso snapshots | iso 0.3 surfaces at cycles 0, 10, 20, 28 (saved odbs), three views each | `iso_mt.py` on the saved odbs (`SAVE.odb/..._010`, `_020`, `c28.odb`), rendered here | nexus: `iso_mt.py <odb> 0.3` per cycle (about 3 min each); render here | Miguel 15 min; here 30 min |
| 4 | GPS deck failure and the keel fix | sections of the iso 0.3 / 0.4 / 0.5 TUB under the deck (keel empty) | `fig_r4_deck_sections.png`, `fig_r4_deck_long.png` (`fig_r4_deck.py`) | exists | - |
| 5 | Keel variants | S, L, A, B shapes in 3D and sections | `fig_r4_keel_variants_3d.png`, `_sections.png`; `keels_r4_1..3_*.png` | exists | - |
| 6 | Island check (rev 2, boss 5) | boss 5 shell separated from the tub at iso 0.4 | `fig_boss5_c31.png` | exists (history, rev 2) | - |
| 7 | Mode shapes of the final TH | modes 7 to 12 of TH_r4b_i30_final: deformed outline (or displacement magnitude on the solid elements) in plan and side view, frequency in the title; answers the spine-tail peak question | small odb export script (U of FREQ frames 7 to 12 on the solid-element nodes to npz), plotted here | nexus: export (about 5 min run); script here 20 min | Miguel 10 min; here 40 min |
| 8 | Design space against result | design envelope (STEP design cells, translucent) with the iso 0.3 print set inside; per part and assembled | `geometry/v04B_r4/*.step`, `print/r4_iso030/*.stl` | here (gmsh + matplotlib, as `r4_assembly_render.py`) | 40 min |
| 9 | Restoration before / after | raw iso 0.3 surface, exact fixed solids, restored part (TUB rear and one arm root) | `mt_c28_*_030.stl`, STEP, `print/r4_iso030/` | here | 30 min |
| 10 | Keel cell clean-up (DV-27) | removed skins (34.1 mm^3) on the TUB rear | `artifacts_keelcell_main.stl` (scratch, can be regenerated by `restore_r4.py` logic) | here | 20 min |

## Print set

| # | Figure | Content | Source | Status | Time |
|---|---|---|---|---|---|
| 11 | Final renders | assembly, parts | `print/r4_iso030/*.stl` (this PR) | STLs here; renders by the main chat (or here, 30 min) | - |
| 12 | Wall thickness T-6 | ray thickness below 0.8 / 0.8 to 1.2 mm on TUB, LID, ARM_pp, three views each | `fig_t6_r4_iso030_TUB.png`, `_LID.png`, `_ARM_pp.png` (`fig_t6_r4.py`) | exists (iso 0.3); iso 0.4 versions `fig_t6_r4_*.png` also exist | - |
| 13 | Thickness distribution | cumulative surface share against thickness, three parts, both methods | `t6_*.npz` (scratch, regenerable by `t6_thickness_r4.py` in about 10 min) | here | 20 min |
| 14 | v04-B design renders (pre-optimisation) | assembly, fixed regions x-ray, lid raised | `r4_render_1..6_*.png` (main chat) | exists | - |

## Model set-up

| # | Figure | Content | Source | Status | Time |
|---|---|---|---|---|---|
| 15 | Mesh | 1.0 mm C3D10 mesh, element counts per part (TUB 391,649, LID 51,191, ARM 4 x 80,603); surface mesh of the TUB with a zoom on a fin | odb export of the boundary faces (nexus) or the CAE model on the laptop (screenshot, Miguel) | nexus export 10 min + plot here 30 min; or CAE screenshot by Miguel 10 min | 40 min |
| 16 | Supports, couplings, ties and loads | 3-2-1 supports on the joint RPs (D-064), the 30 tie and coupling surfaces coloured by type (motor seats, joint and boss ties, FC / GPS / antenna / battery seats, seat tie), point masses, load arrows per case | surface node sets from TH_r4b_i30_final (same lookup as `stress_th.py`) exported on nexus; RP positions `geometry/v04B_r4/reference_points_v04B.csv`; load values from the journal | nexus export 5 min; plot here | Miguel 10 min; here 45 min |
| 17 | Load-case table | LC1, LC2a, LC2b, LC3a definitions and caps | journal, build log item 50 | table, no figure | - |

## Stage 7

| # | Figure | Content | Source | Status | Time |
|---|---|---|---|---|---|
| 18 | von Mises, governing case | LC3a, solid elements, limit scale and P99.9 scale | `fig_stage7_vm_LC3a.png` (`fig_stress_r4.py`, `stress_TH_r4b_i30_final_LC3a.npz`) | exists | - |
| 19 | S33 and shear maps, other load cases | same layout for S33 / TSH or LC1, LC2a, LC2b | npz of the other steps on nexus (written by `stress_th.py`) | nexus: download 3 npz (2 min); plot here | here 15 min |
| 20 | Strength utilisation summary | P99.9 utilisation per part and check (bar chart, all far below 1) | `data/report/stage7_strength.csv` | data exists; plot here | 10 min |
| 21 | Capacity: Z(u) and Z / (u_m - u) | section modulus along the arm with the 260 mm^3 line, slot end u 43.74, minimum of the lever-corrected curve at u 61 | `data/report/stage7_capacity.csv` | data exists; plot here | 15 min |
| 22 | Arm sections | section outlines at u 43.74, 50, 61 (where the arm is weakest) | `capacity_r4.py` slices | here | 20 min |

## Suggested order for the 09:00 compact report

Exists already: 4, 5, 12, 14, 18. Quick from data here (about 1 h together): 1, 2, 20, 21, 8. Nexus-dependent (Miguel about 30 min, here about 2 h): 3, 7, 16. The rest suits the extended report.
