migueldiaslima/drone-revB/figures/gps_cap_1_installed.png

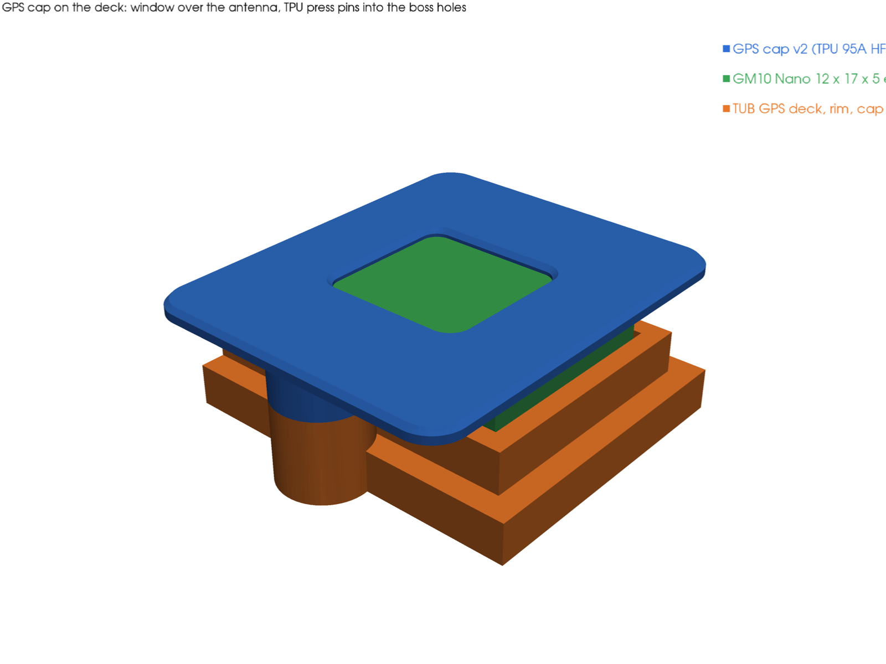
figures/gps_cap_1_installed.png
