migueldiaslima/drone-revB/figures/rx_cradle_2_installed.png

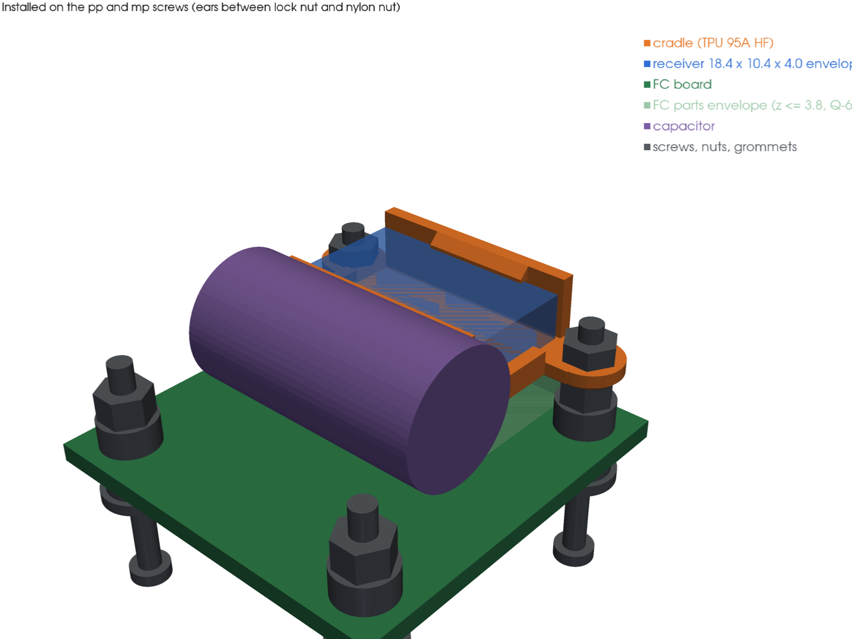
figures/rx_cradle_2_installed.png
