migueldiaslima/drone-revB/scripts/post/test_capacity/README.txt

Analytic check of capacity_r4.py: python3 mkbox.py; python3 ../capacity_r4.py arm.stl tub.stl
Bars 8 x 20 mm and 6 x 16 mm along the pp diagonal: Z = 533.3 and 256.0 mm^3, area 160 and 96 mm^2, z_c -2.0 at
every u, reproduced exactly (2026-10-13).
