migueldiaslima/drone-revB/report/figures/plot_history.pdf

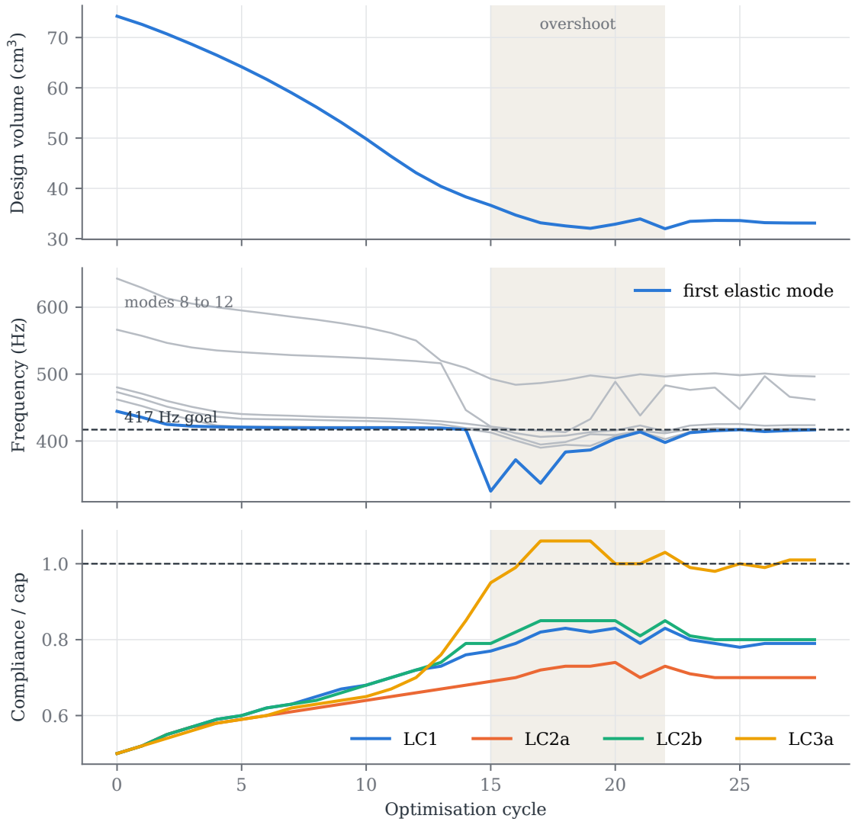
[picture p75: figure]
Desig; olu; overshoot; Frequency (Hz); 417 Hz goal; modes 8 to 12; first elastic mode; Optimisation cycle; Compliance / cap
