migueldiaslima/drone-revB/report/figures/plot_power_models.pdf

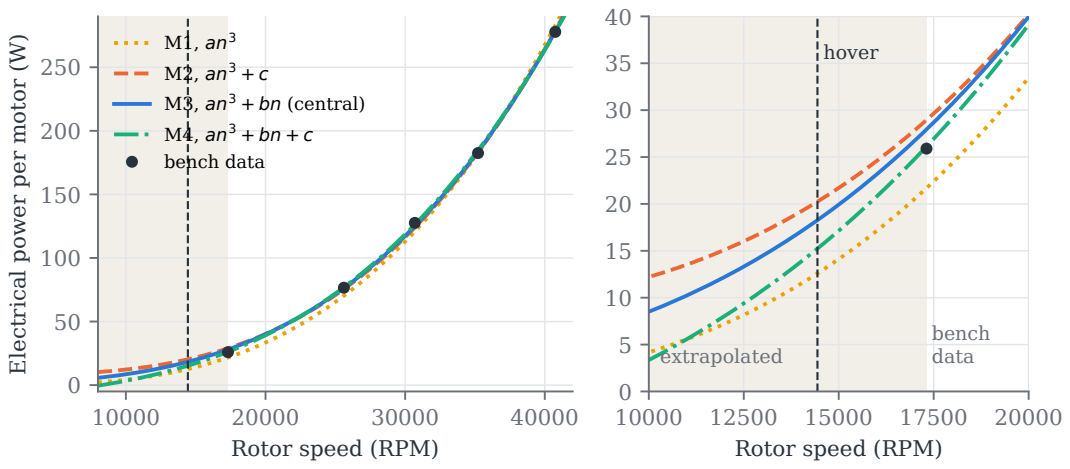
[picture p76: page 1]
3 + bn (central); 3 + bn + c bench data; hover

Electrical power per motor (W)

bench

extrapolated | data

Rotor speed (RPM)
