migueldiaslima/drone-revB/(commit log)

2026-10-12 Initial import: project docs, v04-B and v03-B geometry, scripts by stage, figures
    Claude-Session: https://claude.ai/code/session_018zM96RqrTZe42quThnkr87
    [ARM_mm.step, ARM_mp.step, ARM_pm.step, ARM_pp.step, COMPONENTS_v04B.step, KEEPOUTS_v04B.step, LID.step, TUB.step]
2026-10-12 TH04: build log item 44 and F-17 (antenna boss island); th04_build.py / run_TH04.sh noislands option; CLAUDE.md progress-commands rule
    Claude-Session: https://claude.ai/code/session_01DuqGQM3kTcewrsx2uo6DFB
2026-10-12 F-17 figures: antenna boss in the v04-B design space, proposed fixed link L1, antenna V vs straight T
    Adds scripts/figures/f17_antenna_link.py (2D sections from the v04-B rev 2 generator
    parameters, clearances printed) and figures/f17_1_current.png, f17_2_link.png,
    f17_3_antenna.png. No journal change yet (v0.53 follows on this branch after Miguel's
    decisions on the antenna shape and L1).
    Claude-Session: https://claude.ai/code/session_01UiAjPizYnRHcGHe8vGysaV
2026-10-12 F-17: concept C2 figure (fixed conduit around K8 and K9, chained to the keel lid boss; straight T antenna)
    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
2026-10-12 F-17: interactive 3D viewer of the antenna mount options (as exported, on the GPS cap, under the keel with sleeve and web)
    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
2026-10-12 F-17: antenna spine concept (smooth fixed pad + K8 sleeve + web into the rear lid boss, K9 moved 1.5 mm), TPU holder detail, viewer v2
    Adds scripts/figures/f17_antenna_spine.py (signed distance field with smooth unions, marching
    tetrahedra; prints volume 1,041 mm^3 = 1.35 g and clearances: K9 moved 1.51 mm, keel side 1.20 mm)
    and figures/f17_spine_mesh.json; updates docs/f17_antenna_viewer.html (spine surface, holder,
    coax loop, measured coax 62 mm).
    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
2026-10-12 F-17: v04-B revision 3 proposal - validated antenna spine, printable TPU holder, K8 R7 reroute, K9 moved
    - scripts/geometry_main/s06_f17_spine.py: spine and holder as signed distance fields, 34 checks
    (all pass), STL exports and viewer mesh (geometry/v04B_r3_f17/)
    - scripts/geometry_main/s06_geometry_v04B.py: revision 3 (antenna spine replaces the antenna boss,
    K8 z 6.5 with one R7 bend to (-49, 3.5), K9 and lid GPS hole moved 1.5 mm to -y, straight T
    components, RP_ANT and rebalanced point masses); syntax-checked only, CadQuery not available here
    - docs/stage6_v04B_r3_F17_note.md: changes, check table, holder print spec, open assumptions
    - docs/f17_antenna_viewer.html: viewer v3 on th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
    [s06_f17_spine.py, s06_geometry_v04B.py]
2026-10-12 F-17 note: how to regenerate the git-ignored STL files
    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
2026-10-12 F-17 rev 3: measured antenna (legs 1.4, span 52), C-clips wrap 277 deg, generator and gates run from the repo layout
    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
2026-10-12 v04-B revision 3 built and gated (G0 to G5 pass); journal v0.53 (N-06-17 to N-06-19, F-036, L-015, D-083 to D-085)
    - geometry/v04B_r3/: TUB, LID, ARM_xx, KEEPOUTS, COMPONENTS STEP, reference points (RP_ANT,
    199.58 g), volumes, gate log and json (CadQuery 2.8)
    - s06_geometry_v04B.py: pad front x -41, web = rear lid boss continued down (G3), peg (-43.5, -5.3)
    - s06_gates_v04B.py: G0 arm identity by vertices and volumes (OCP 7.8 coincident-solid Booleans),
    relative volume tolerance, G1 expected envelope clips the spine tool, G4 baseline from the rev 2 record
    - s06_f17_spine.py: same changes, 35 checks pass
    - docs: stage6_v04B_r3_export_note.md (for the set-up chat), F-17 note updated, READM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
    [ARM_mm.step, ARM_mp.step, ARM_pm.step, ARM_pp.step, COMPONENTS_v04B.step, KEEPOUTS_v04B.step, LID.step, TUB.step]
2026-10-12 Figures: seat band (Option A) on the rev 3 tub; skid clamped by the FC screws
    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
2026-10-12 iso_mt.py / iso_stl.py: part filter (TUB, LID, ARMS) and keel crop; build log item 47
    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
2026-10-12 iso_stl.py: density from the last frame that holds it (frame 0 of c31.odb has none)
    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
2026-10-13 v04-B revision 4 (F-18 fix, option D): GPS deck on the TUB, four lid bosses
    - s06_geometry_v04B.py: GPS deck, pocket rim and cap bosses moved to the TUB
    (gps_deck_tools, y +-9 flush with the keel); lid ends at x -32 with 0.5 mm gap;
    boss 5 deleted; fixed pad links 4.5 mm; K9 up to the pocket floor; RP_GPS
    coupled to the TUB; output geometry/v04B_r4.
    - s06_gates_v04B.py: G3 feature lists for rev 4 (deck on the TUB, pad links).
    - s06_cae_expected_v04B.py: expected surface areas and cells for the CAE rebuild.
    - geometry/v04B_r4: STEP, reference points, volumes, gates G0 to G5 PASS, CAE expected values.
    - docs: journal v0.54 (F-037, D-086, N-06-20, L-016), stage6_v04B_r4_export_note.md, RE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
    [ARM_mm.step, ARM_mp.step, ARM_pm.step, ARM_pp.step, COMPONENTS_v04B.step, KEEPOUTS_v04B.step, LID.step, TUB.step]
2026-10-13 v04-B rev 4 renders: assembly with design (free) and fixed regions
    - scripts/figures/r4_assembly_render.py (pyvista, reads geometry/v04B_r4)
    - figures/r4_render_1..6 png
    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
2026-10-13 Receiver cradle v1 (TPU 95A HF): generator, checks, renders, note; journal v0.55 (Q-61, Q-62)
    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
    [RX_CRADLE_v1.step]
2026-10-13 Receiver cradle v2: Q-61 and Q-62 answered (lip at 4.1, +y lip clear of the IPEX plug), Q-60 checked at first fit
    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
    [RX_CRADLE_v2.step]
2026-10-13 Keel proposals A and B: keels_r4.py (shapes and preview STLs), note stage6_v04B_r4_keel_note.md; build log item 55
    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
2026-10-13 TH_CLEAN (leftover design material in a box set to air, fixed kept, shapes override); offline test; build log item 57
    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
2026-10-13 Keels A and B (D-087): exact solids for the rev 4 restoration; journal v0.56
    - s07_keels_r4.py: keel A (2 solids) and web B with the rear wall gusset (to z -2.0, 1 mm above the
    K11 opening at z -3.0); deviations D1 to D4 for printable, mesh-clean solids; clash, G2, G3 checks
    - geometry/v04B_r4_keels: KEEL_A_r4.step, KEEL_B_r4.step, KEEL_ZONE_r4.step, keels_r4_checks.json
    - keels_r4_render.py, figures/keels_r4_1..3.png
    - docs: stage6_v04B_r4_keels_export_note.md; journal v0.56 (N-06-21, N-06-22, F-038, D-087, D-088, L-017); README
    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
    [KEEL_A_r4.step, KEEL_B_r4.step, KEEL_ZONE_r4.step]
2026-10-13 Keel B rev b: straight lower edge to the rear wall face (Miguel), D5
    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
    [KEEL_A_r4.step, KEEL_B_r4.step, KEEL_ZONE_r4.step]
2026-10-13 restore_r4.py: rev 4 print set restoration with T-5 and T-7 reports; build log item 59
    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
2026-10-13 restore_r4.py: weld gmsh meshes by coordinates, drop doubled faces, diagnostics on a non-manifold solid
    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
2026-10-13 T-6 wall thickness of the rev 4 print set: script, maps, build log item 61
    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
2026-10-13 Build log item 63: rev 4 print set at iso 0.3 (restoration, T-5, T-6, T-7), T-6 maps
    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
2026-10-13 GPS cap v1 (TPU 95A HF): generator, checks, renders, note; Q-63
    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
    [GPS_CAP_v1.step]
2026-10-13 GPS cap v2: TPU press pins dia 3.325 in the boss holes instead of screws and inserts (Miguel); plate 0.8
    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
    [GPS_CAP_v1.step, GPS_CAP_v2.step]
2026-10-13 TH04 keels: add the keel STLs (excluded by the *.stl ignore rule), clear message for an empty STL
    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
    [KEEL_A_r4.stl, KEEL_B_r4.stl]
2026-10-13 Build log item 65: final T-4 TH on the print geometry (iso 0.3, exact keels): PASS
    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
2026-10-13 H4 rev 4 report: H4 run, keel fix, print set, T-1 to T-7, final T-4
    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
2026-10-13 Stage 7 brief (route A); journal: D-089, N-06-23, F-039
    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
2026-10-13 Stage 7 route A: stress_th.py, TH_STRESS option, capacity_r4.py with tests; build log item 66 (D-050 CHECK)
    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
2026-10-13 Stage 7 brief: TUB printed floor-down (Miguel), recorded in D-089
    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
2026-10-13 stress_th.py per the Stage 7 brief (centroid values, three checks, weighted P99.9, clusters, tie/coupling exclusion, top ten), figure script, D-050 table u 45 to 55; build log item 67
    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
2026-10-13 Build log item 68: Stage 7 stresses, all checks PASS (max utilisation 0.04)
    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
2026-10-13 Journal: F-040 (D-050 not met, lever note), D-090 (stated as limitation); brief: u from the frame centre
    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
2026-10-13 F-040, D-090: joint outcome expected from first principles; prong fuse as the redesign
    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
2026-10-13 Stage 7 report, capacity additions (fork exit, lever ratio, fin root), figure; build log item 69
    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
2026-10-13 Journal v0.59: Stage 7 recorded (N-07-01, N-07-02), F-040 and D-090 corrected; Stages 6 and 7 closed; README
    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
2026-10-14 Add Stage 2 theory doc 'sizing model from first principles' rev 34 (md + pdf, exported from Claude Docs)
    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
2026-10-14 Print set iso 0.3 STLs for the report renders (force-added, *.stl is ignored)
    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
    [print_ARM_pp_r4_iso030.stl, print_LID_r4_iso030.stl]
2026-10-14 Report data CSVs: H4 rev 4 history, TH comparison, Stage 7 strength and capacity
    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
    [h4r4_history.csv, stage7_capacity.csv, stage7_strength.csv, th_comparison.csv]
2026-10-14 Compact report: renders (Blender Cycles, print geometry and representative components), plots from data/report, figures wired in
    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
    [h4r4_history.csv, stage7_capacity.csv, stage7_strength.csv, th_comparison.csv]
2026-10-14 Compact report: truth and language passes (sections 04 to 10)
    Joint capacity number format fixed (21216 N mm), EI wording in the layout
    section, capacity ratio derivation shown step by step, web B only row in the
    keel table, filler sentences removed.
    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
2026-10-14 Extensive report: chapter 4 (loads), Campbell and power-model plots
    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
2026-10-14 Extensive report: chapter 5 (material selection), merit index plot
    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
2026-10-14 Extensive report: chapter 6 (architecture, joint, design space); compact: battery plate height wording
    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
2026-10-14 Extensive report: section 11.4 capacity and failure order (separate file 11b_capacity.tex)
    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
2026-10-14 Extensive report: capacity figure in 11.4
    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
2026-10-14 Extensive report chapter 10: thresholded verification and print geometry; figures su_restoration_tub, su_t6_lid, su_t6_arm; number sources
    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
2026-10-14 Extensive report chapter 11, sections 11.1 to 11.3: strength criteria, evaluation on the thresholded mesh, results; figure su_strength_vm_LC3a; number sources
    - report/extensive/chapters/11_strength.tex: allowables and criteria, evaluation rules, results table and figure; 11.4 left as a placeholder for the main chat; source comment block W1 to W8
    - report/figures/su_strength_vm_LC3a.png: report version of the landing-case von Mises figure (no internal job name in the title, volume-weighted P99.9 scale)
    - scripts/figures/fig_strength_vm.py: script for that figure
    - docs/report_sources/11_strength.md: sources W1 to W8
    Claude-Session: htt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
2026-10-14 Chapter 8: iso-density snapshots of the production run and coupling and tie surface figure (from the nexus figure run); source S14
    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
2026-10-14 Chapter 10: mesh and mode-shape figures of the final check, modal participation table (antenna pad, lid, GPS seat, motor seats); spine-tail reading corrected (mode 11 is a tail mode); source V10
    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
2026-10-14 Figure scripts after the nexus run: plain part names in the mesh title, lid excluded from the zoom, joint couplings separated from the boss ties in the set-up legend, legend markers fixed, no volumes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
2026-10-14 Report stage close: covers, compact headings and full-report sentence (commits pushed after #45 merged), 11.4 placeholder removed, journal v0.60 and README status
    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
